SumatiGupta/ASL-Glove-Project/Final Report.pdf

# Project Report: ASL Glove

11/30/2021

Team Members:
Haritha Patil, Indraja Venigandla, Sangam Shrestha, and Sumati Gupta

Table of Contents

Introduction | 4
Problem Description | 4
Project Description | 4
Background | 4
Theory of voltage divider and Operation of Flex Sensors | 4
Theory of UART | 5
Theory of Bluetooth | 6
Theory of I2C and SPI | 6
Operation of HC-05 BT Module | 7
Theory of DMA | 8
Individual aspects of the project | 8
PIT | 8
ADC and DMA triggered ADC | 8
UART and HC-05 connections | 9
I2C, SPI and LCD Screen | 9
16 - segment Display | 11
Calibration and Decode Software | 12
Overall Block Diagram and Flowchart | 14
Results | 17
Performance | 17
Limitations | 17
Alternatives and/or future work | 17
Parallel ADC readings | 17
Increase accuracy | 17
Currently, we take readings from only flex sensors and while this works well most of
the time, there are some inaccuracies due to two factors. | 17
PCB | 18
Since using breadboards is bulky and the external wires can lead to loose connections, we would design and solder a printed circuit board for a more sturdy platform on which the glove operates. This would also lead to a more robust product,
capable of being used in an easier manner. | 18
LCD Screen | 18
Power supply | 18
Video Links showing different Stages of progress | 18
Summary | 19
Reference List (APA Citations) | 19
Appendices | 20
Appendix A | 20

Code for PIT source file | 20
Code for PIT header file | 21
Code for ADC source file | 21
Code for ADC header file | 23
Code for DMA source file | 24
Code for DMA header file | 26
Code for UART TX source file | 26
Code for UART TX header file | 31
Code for Mode detect source file | 32
Code for Mode detect header file | 33
Code for main source file on Transmission MCU | 34
Code for main header file on Transmission MCU | 35
Code for UART RX source file | 35
Code for UART RX header file | 39
Code for calibration and letter decode source file | 39
Code for calibration and letter decode header file | 54
Code for 16 segment source file | 55
Code for 16 segment header file | 60
Code for main source file on Reception MCU | 60
Code for main header file on Reception MCU | 61
Appendix B | 62
Segments of MCU reference Manual | 62
HC-05 Bluetooth Module datasheet segments | 63
16-segment display datasheet segments | 64
Appendix C | 64
Information on data formats and slave devices for I2C. | 65

Introduction

Problem Description
Most people have a hard time understanding American Sign Language (ASL). When they come across a situation where they need to communicate or understand sign language, they require a human or electronic translator. This leads to alienation and miscommunication between two groups of people.

To reduce such alienation, we propose a child-friendly educational tool which will help people get acclimated to and learn sign language.

Project Description
The aim of this project is to design a glove that can be used to teach the ASL alphabet. This glove will have flex sensors integrated into it, which will detect and keep track of various gestures for alphabets used in ASL and display them on a 16-segment display.

Background

Theory of voltage divider and Operation of Flex Sensors
When a voltage source is applied across two resistors in series (where one is connected directly to the source and the other is connected to ground), there is a voltage drop that can be measured across the resistor connected to ground. This voltage drop is the divided voltage and is often referred to as the Vout . The formula used Vout to calculate is:
Vout = Vin * R2___ R1 + R2
, Given the setup in Figure 1

Figure 1: General Voltage Divider circuit [1]

The flex sensor is a resistor that changes resistance based on the bend of the sensor. We connect it in a similar manner to the voltage divider circuit [2]. The Vout

is measured using the
ADC peripheral of the Board. R1 is the flex sensor, R2 is 47kΩ or 51kΩ based on Table 1 and 2, Vin is 5 V output from the MCU and GND is GND from the board

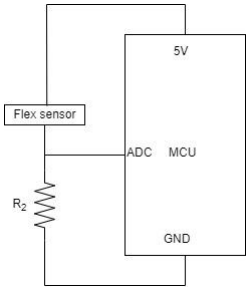
[picture p1: figure]

Figure 2: Flex sensor circuit

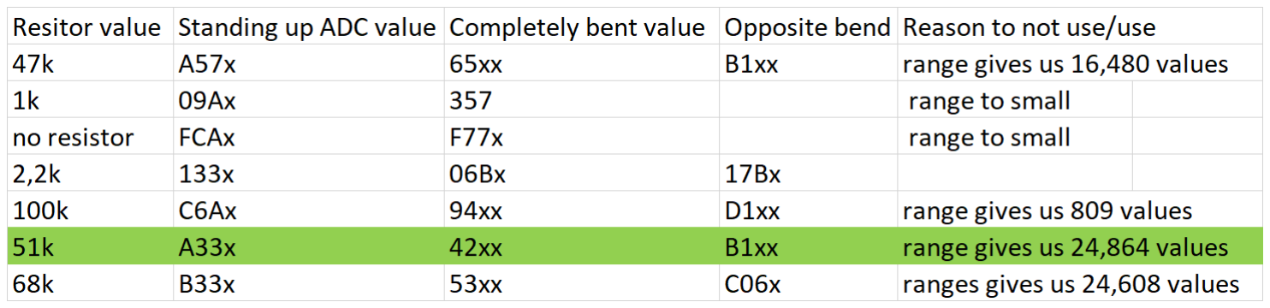
[picture p2: figure]

Table 1: The values from different resistors for small flex sensors. The highlighted one was determined as the best one to use. Here “x” means, it’s fluctuating. Empty cells represent a range that was too small to take into account.

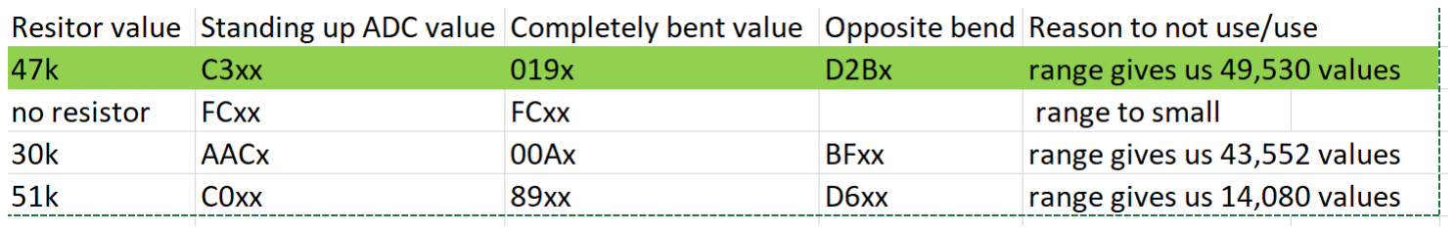
[picture p3: figure]

Table 2: The values from different resistors for long flex sensors. The highlighted one was determined as the best one to use. Here “x” means, it’s fluctuating. Empty cells represent a range that was too small to take into account

Theory of UART
UART stands for Universal Asynchronous Receiver Transmitter. It is a peripheral used for serial communication. The data format and baud rate is configurable using registers on the MCU. Based on configuration, it can be configured to be only a transmitter, only a receiver or both. The transmitter uses a shift register to convert input data to serial data and the receiver uses a shift register to convert serial data into parallel data.

Baud rate refers to the rate at which data is being transferred in bits per second. It is set using the formula, Baud rate = bus clock frequency/(SBR * (OSR +1)), where SBR can be set in BDH and BDL registers and OSR refers to the oversampling rate.

The oversampling rate is used to estimate the middle points of transmitted bits and retrieve these points accordingly [3]. This means that each incoming bit is sampled OSR times and a majority vote is taken.

In our case, the format of data being sent is one start bit, one byte of data, one stop bit

Figure 3: Data format being transmitted and received

Theory of Bluetooth
Bluetooth is a short-range wireless technology standard that is used for exchanging data . A Bluetooth device works by using radio waves instead of wires or cables. [5]

Theory of I2C and SPI
I

2C (Inter-Integrated circuit) bus and SPI (Serial peripheral interface) are used for synchronous serial communication. While I

2C can be used with one master or multiple masters and a single or multiple slave devices, SPI can work with only one master and one or multiple slave devices.

I

2C uses serial data (SDA) signal and serial clock (SCL) signal. A slave may not transmit data unless it has been addressed by the master. Each device on the I2C bus has a specific device address. In our case, since we attempted to work with only one LCD screen as the slave device, we did not need to configure it for multiple slave devices.

In our case, we tried to send data to a slave device (LCD screen and data format is as follows):

Figure 4: Data format that was being sent to screen [6]

In SPI, The MCU is the master and peripheral devices are slaves. In our case, our slave device is the LCD controller. SPI communication between a master and slaves uses three signals(clock and two data signals), a select signal for each slave and ground.
- The clock signal (known as SCK).
- The MOSI data signal is the master output and slave input.
- The MISO data signal is the master input and slave output.
- The SS signal - Slave Select signal.

Baud rate refers to the rate at which data is being transferred in bits per second. It is set using the formula, SPI baud rate = bus clock frequency/((SPPR+1)*2SPR+1), where SPPR and SPR can be set in the SPIx_BR register and I2C baud rate = bus speed/(mulx SCL divider) which can be sent in F register using Table 38-41 in reference Manual (See Appendix B)

Operation of HC-05 BT Module
The HC-05 has EN, VCC, GND, TX, RX, and STATE pins. The HC-05 Bluetooth (BT) Module has two modes “ AT Command '' mode and operation mode. HC-05 Module’s are slaves by default and able to recieve data at the default baud rate and settings.

However to configure the module, we need to go into AT Command mode and configure details of the BT Module. To do this, we require an FTDI reader and the tera term software. We connected the FTDI reader (Micro USB to TTL Serial Converter Adapter) to the computer and once it was detected by the computer’s COM ports. After that, we connected the Rx pin of the FTDI reader to the Tx pin of the Module and the Tx pin to the Rx pin. After which we shorted the Vcc and EN pins of the HC-05 and then we connected the Vcc of the reader to BT Module. The LED on the Module blinked every two seconds indicating it was in AT mode [4].

Once it was in AT mode, we used the tera term software to send data to the HC-05 and using the commands in the HC-05 Datasheet, we set the following configurations.

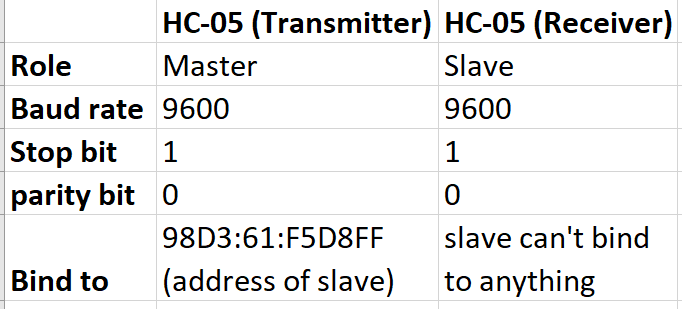
[picture p4: figure]

Table 3: Configurations of HC-05 BT Module’s, Note: Master has to bind to slave address to ensure it always connects to that particular slave device. The address of the slave device was found using an AT command: AT+ADDR?

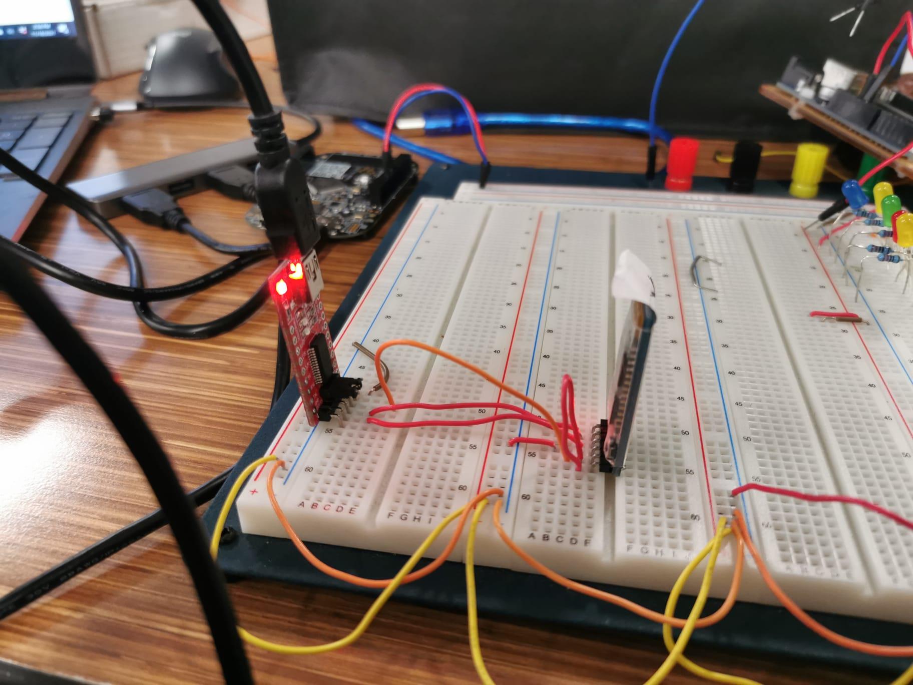
[picture p5: figure]

Figure 4: Connection between HC-05 and FTDI reader

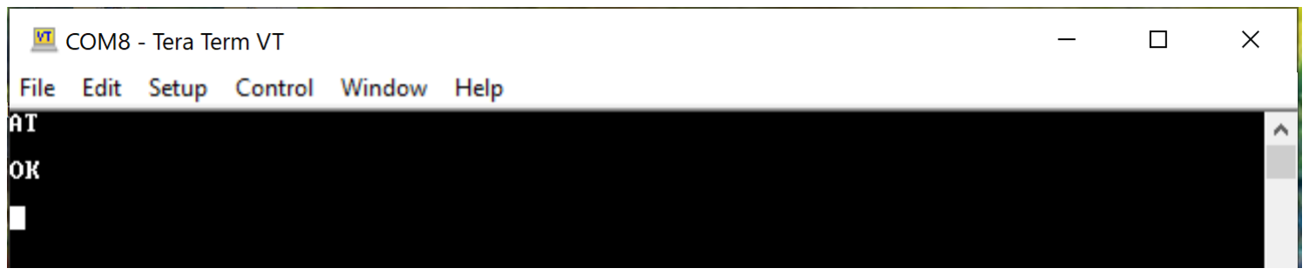
[picture p6: figure]

Figure 5: Picture of Tera Term software

This process is how we ensure that the HC-05 Modules don’t connect to any other bluetooth devices in the vicinity.

Theory of DMA
DMA stands for Direct Memory Access. This peripheral can directly access the MCU’s memory bus directly instead of relying on store and load instructions. Different peripherals can trigger a DMA request. In our case, each ADC conversion triggers a DMA request.

Individual aspects of the project

PIT
The timer PIT is initialized such that 2 channels are utilized. Channel 0 is used for polling adc values every 10 ms by loading 5DBF (10ms*24Mhz - 1 = 23999 cycles or 5DBF) in the LDVAL register for channel 0, and calling a function that starts ADC conversion in the IRQHandler.

Channel 1 is used for updating the flag that indicates mode of operation of the program based on a switch input. Mode of operation refers to calibration mode or performance mode. Once the switch is pressed, it will update every 2 seconds until calibration is over. This is done by loading 2DC6BFF (2*24Mhz - 1 = 47999999 cycles or 2DC6BFF) in LDVAL register for channel 1.

Neither channel uses chaining. The IRQHandler uses the TIF flag in the TFLG register to check which channel triggered the interrupt. The timer restarts when calibration mode is set to avoid unsynchronized data transmission. See Appendix A for code.

ADC and DMA triggered ADC
The ADC is initialized such that there are 5 ADC pins and it is DMA enabled. It uses a 16-bit mode and uses a calibration function after each conversion for accuracy purposes. Once an ADC conversion is over, it triggers the DMA and the DMA transfers the ADC value into an array called GloveInputs. This is done by setting the DMA source to ADC, setting the Source address register in DMA to the result register of the ADC and the Destination address register to the array. We use DMA in circular buffer mode. We increment the destination address, making sure it stores the values sequentially in the correct index value of GloveInputs. Each time a transfer of 16 bits is over, the DMA interrupt occurs, indicating it’s done. We have a counter to keep track of this. See Appendix A for code.

UART and HC-05 connections
We used AT mode as described in “Operation of HC-05” in the Background Section.We use UART0 and UART1. We connected to the UART0 TX pin of the Transmitter MCU (reading glove inputs) to RX of master HC-05 and the UART0 RX pin of the Receiver MCU (displaying the values) to the UART0 TX of the slave HC-05.The UART1 TX pin of the Transmitter MCU is connected to the UART1 RX pin of the Receiver MCU.

We configured both baud rates to 9600 in 8 bit mode. There is one stop and no parity bit.

The Transmitter MCU sends five 16 bit values of ADC and one calibration flag 8 bits at a time using polling once the DMA finishes populating all the elements in GloveInputs. After the values in the array are transmitted, transmission stops until DMA is triggered again. UART1 transmits “1” when UART0 is transmitting valid data and “0” when not.

The receiver MCU interrupts whenever it receives a UART1 transmission, if the value is not 0, it will consider UART0 values as valid inputs and populate an array called “receivedADCread” and decodes the calibration flag to find out mode of operation. The way it populates this array is, it combines two 8 bit values in one 16 bit value and places it an appropriate index (index indicates which finger). See Appendix A for code.

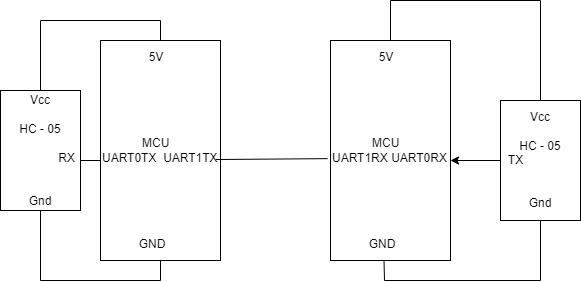
[picture p7: figure]

Figure 6: UART schematic

I2C, SPI and LCD Screen
The SPI is initialized and verified using the SPI loopback test where we figured out the SPI is initialized and the MOSI is sending the data. The figure 5 shows the circuit connection for the SPI initialization. Later, we tried initializing the LCD using the LCD datasheet but couldn't initialize the LCD. The SPI was not sending data to the SPIx_D register. After various consultations with course staff, we moved on to an I

2C LCD screen.

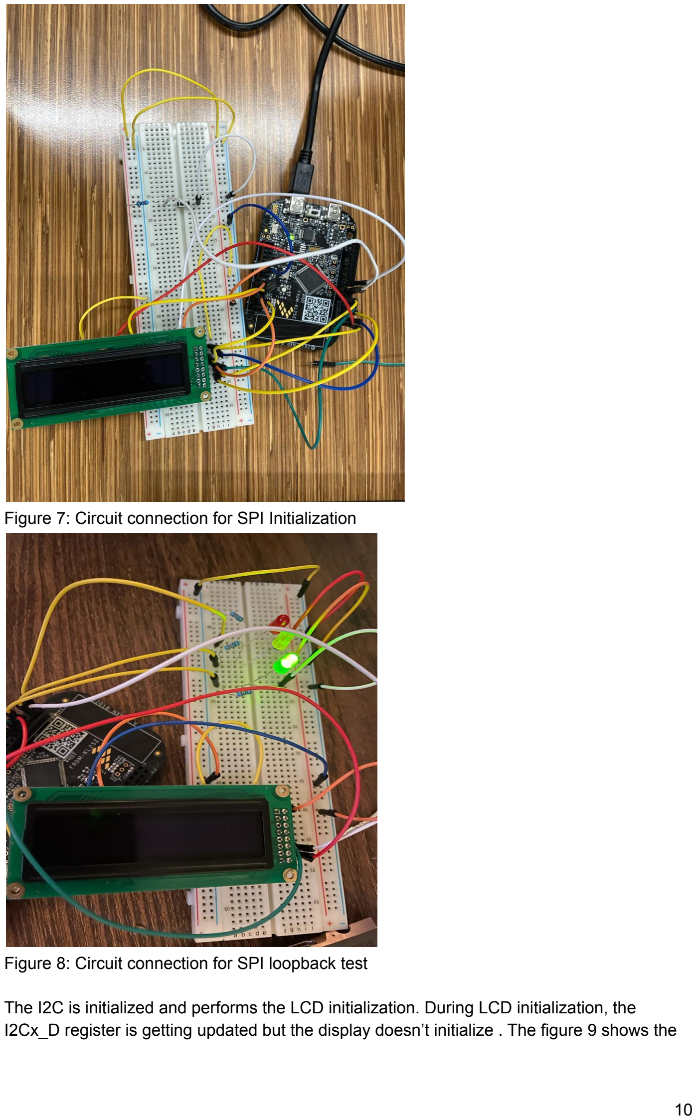
[picture p8: page 10]

Figure 7: Circuit connection for SPI Initialization

Figure 8: Circuit connection for SPI loopback test

The I2C is initialized and performs the LCD initialization. During LCD initialization, the I2Cx_D register is getting updated but the display doesn’t initialize . The figure 9 shows the circuit connection for I2C initialization. Attached is the debug screen shot for the reference as the figure 10.

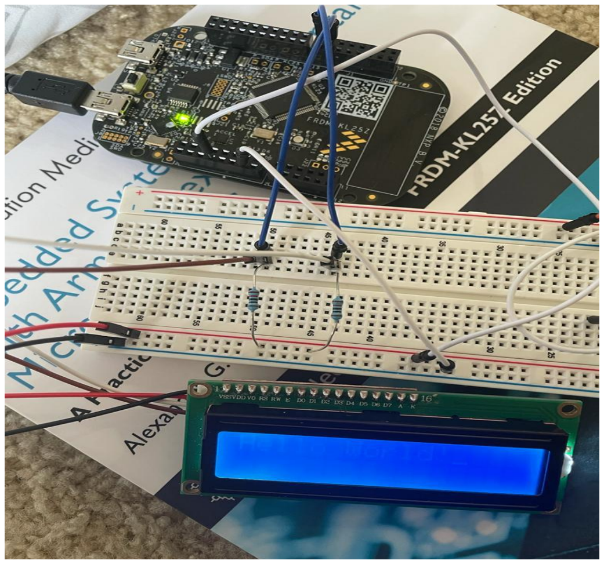
[picture p9: figure]

Figure 9: Circuit connection for Initialization of I2C

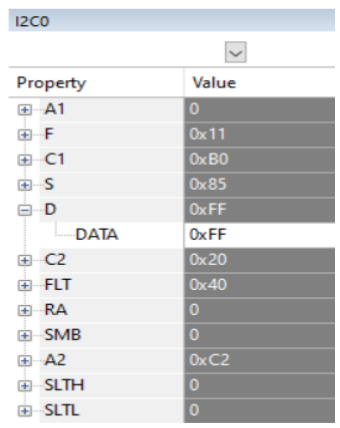
[picture p10: figure]

Figure 10: Debug screen showing D register getting updated

Unfortunately within the scope of our course (the time available), we are unable to figure out the issue. So, we moved on to a 16 segment display.

16 - segment Display
The 16 segment display works with the GPIO. The 16 segments of LED are designated as a,b,c,d,e,f,g,h,k,m,n,p,s,r,t,u and see the figure 11 for reference. We connected all the GPIO ports of the MCU configured as outputs. The segment display receives the input from the decode function and activates the corresponding GPIO ports and displays the output according to that. See Appendix A for code.

Figure 11: 16 Segments of LED

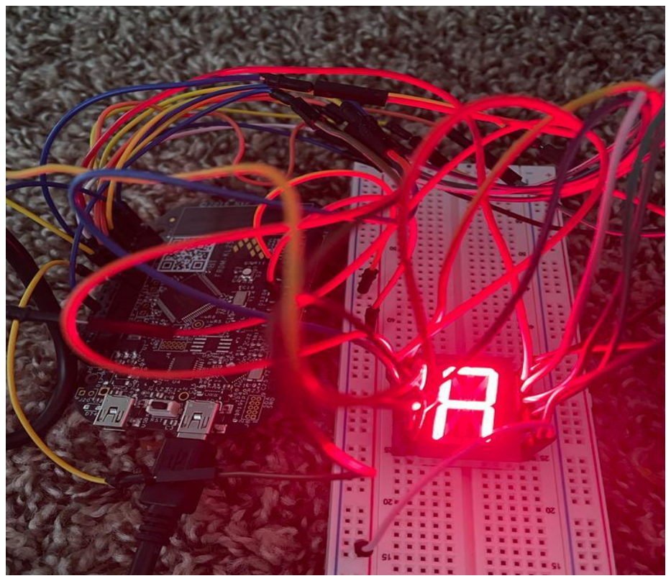
[picture p11: figure]

Figure 12: Circuit connection for 16 Segment display

Calibration and Decode Software

The calibration process is a way to ensure that each set of values read by the ADC can be reliably, and repeatedly mapped to the different letters in the ASL. After the calibration is done, any values read by the ADC needs to be decoded so that the glove knows what letter to display. Both the calibration and decoding procedures are explained in this section:

Calibration

Since the system needs to be able to repeatedly display the same letters given a certain combination of flex sensor readings, it is important to first establish a reference with respect to which we can measure the flexion of the flex sensors. We anticipated that there are three base references that we must establish: the range of values which corresponds to the flex sensor being in the “standing up” position, the range of values which corresponds to the flex sensors being in the “bent” position, and the range of values which corresponds to the flex sensors being in a position that is intermediate to the previous two. This position is referred to as the “middle” position.

This process has a user interface. When the green LED on the freedom board lights up, this means that the MCU is calibrating for the “standing” position, and so the user should keep their hand as straight as possible, so that there is minimal flexion impressed on the flex sensors. After some time, the LED turns red which signifies that the MCU is calibrating for the “bent” position. In this stage, the user should bend his/her fingers so that maximum flexion is impressed on the sensors. After some time, the LED turns off and this means that the user should return to the standing position.The “middle” position is taken as the arithmetic average of the standing and bent positions.

The generated values above are from the user. However, to determine a range of values over which the flex sensor is considered to be in one of standing, middle or bent positions, we need another set of values to which we compare the values generated by the user following the above procedure. This new set of values has been embedded into gloves itself at manufacturing time. We have individually tested each flex sensor and recorded what values they read when configured in the standing, middle and bent positions.

The ranges for the standing, middle and bent positions, then, can be calculated as the difference of the user-generated values and the embedded values. In this way, whenever the ADC detects a particular set of values, it will fall in one of these ranges and we can then use a look-up table (explained below) to determine which letter corresponds to the detected set of values.

Decoding

The look-up table is the data structure which helps in the decoding process. This table is a 2-dimensional array (it contains 26 by 5 elements) which takes the 26 letters of the alphabet and mandates what combination of 5 ADC/flex sensor values (one from each finger) should correspond to that letter.

Once this array is established, then any set of values read by the ADC can be corresponded to a letter and will be displayed on the 16-segment display.

The code to execute the calibration and decoding processes are given the appendix.

Overall Block Diagram and Flowchart

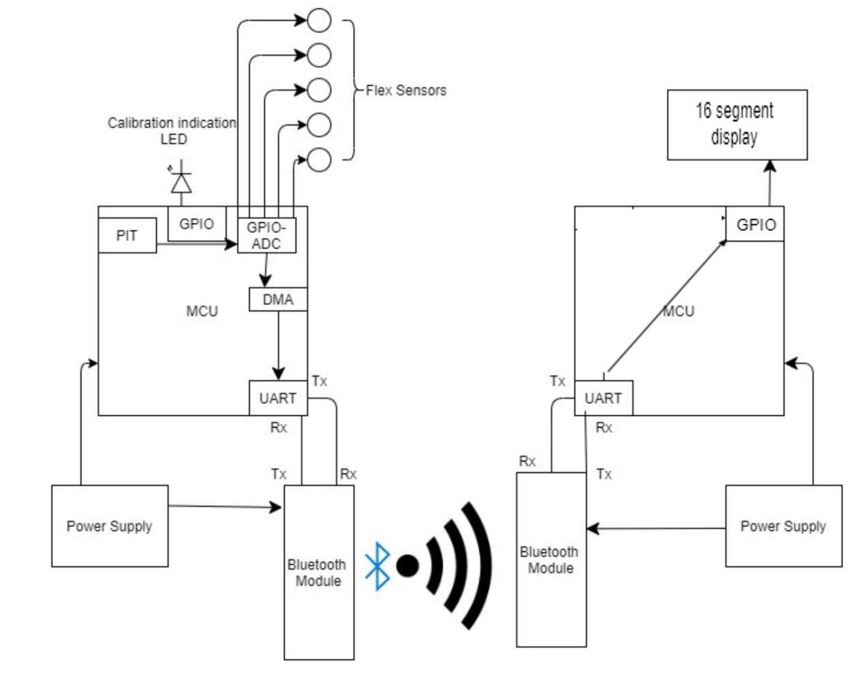
[picture p12: figure]

Figure 13: Block Diagram for overall product

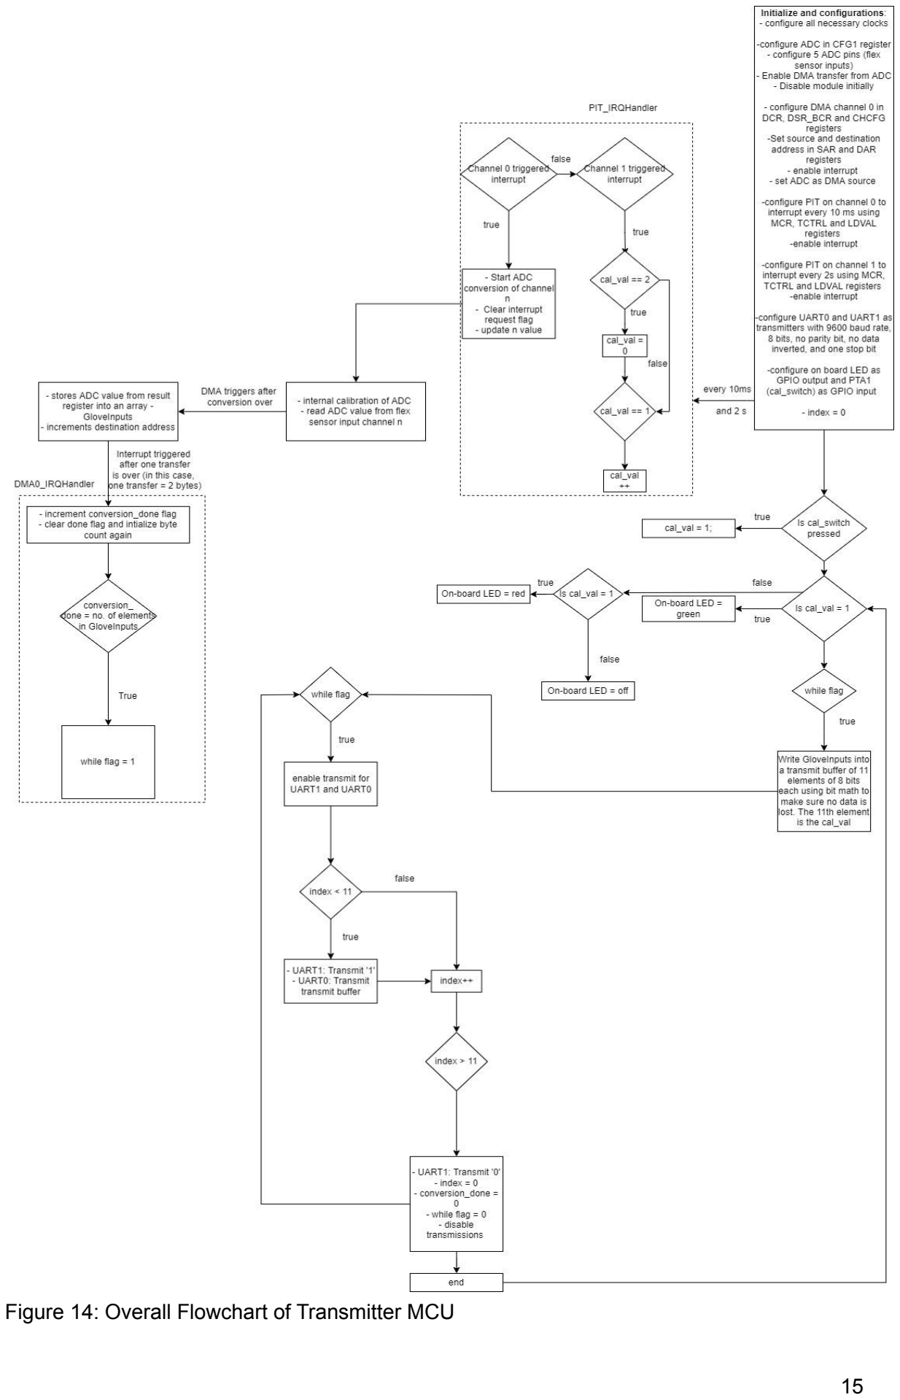
[picture p13: page 15]

Fig

u

r

e

1

4: O

v

e

r

all Flo

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
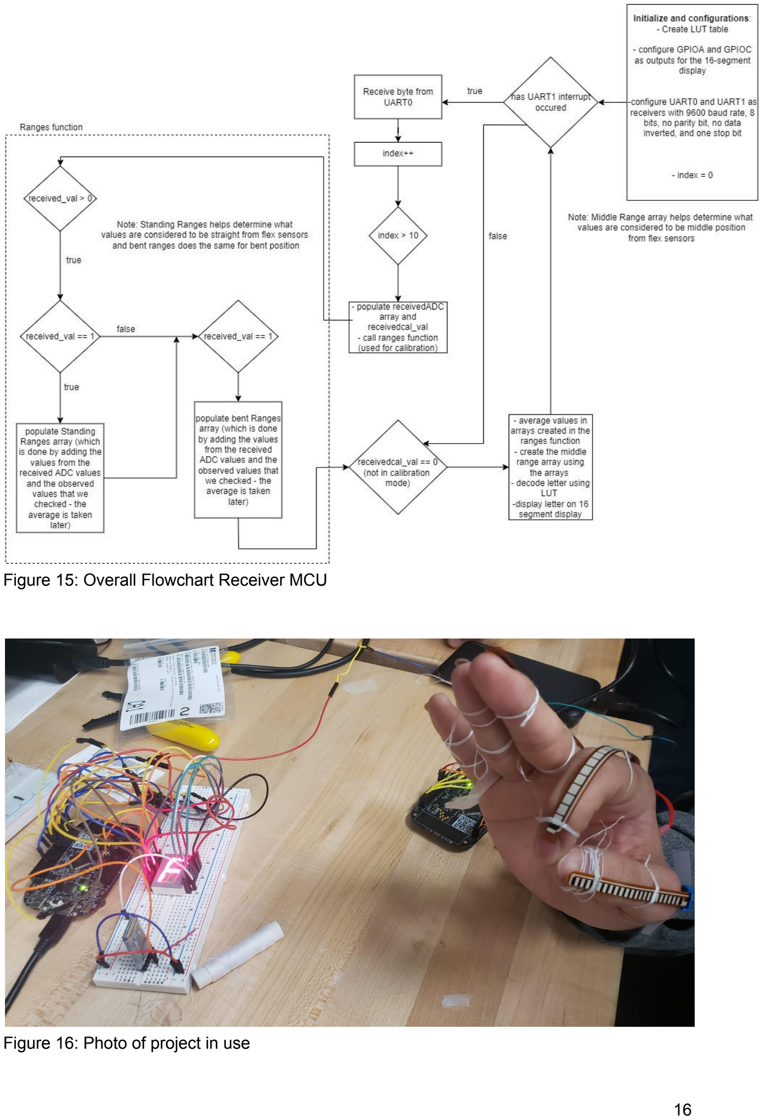
[picture p14: page 16]

Figure 15: Overall Flowchart Receiver MCU

Figure 16: Photo of project in use

Results

Performance

The timers, ADC, DMA, UART, Calibration and letter decoding functions work as expected and the project displays the letter on the segment as expected. When we sign a letter with the flex sensors attached, it is reflected on the screen.

Limitations

1. The flex sensors aren’t stabilized when they are attached to the hand which leads to fluctuating values and the need to be precise in hand positions..
2. Since we can’t determine movement in the fingers, some letters are hard to differentiate. For example the signs for “i” and “j” are the same, except that there is “J” movement with the pinky for “j”.

Figure 17: ASL Letters for i and j

Alternatives and/or future work

Parallel ADC readings

Currently, we sequentially read the ADC values from various pins instead of in a parallel manner. This decision was made after discussion with course staff. However, in the future, it would be efficient if we were able to read it in parallel.

Increase accuracy

Currently, we take readings from only flex sensors and while this works well most of the time, there are some inaccuracies due to two factors.

One factor is that the flex sensors aren’t stabilized when they are attached to the hand and the second factor is that certain ASL letters don’t depend on only the bend angle of the fingers but also movement of fingers. In order to pinpoint the exact location of the hand, we would need to include a gyroscope or an accelerometer.

PCB

Since using breadboards is bulky and the external wires can lead to loose connections, we would design and solder a printed circuit board for a more sturdy platform on which the glove operates. This would also lead to a more robust product, capable of being used in an easier manner.

LCD Screen

We are currently using a 16-segment display. We would like to incorporate an LCD Screen in the future in order to reduce the amount of wires/connections necessary. An LCD screen utilizing the I2C communication protocol only requires 4 wires to power up and use, compared to the 16 connections required for a 16-segment display. Another benefit of the LCD screen is that it is more scalable compared to the 16-segment display. An immediate expansion to the product is the incorporation of words and phrases. An LCD screen would easily allow the user to see what is being said when a certain gesture is made.

Power supply

We are currently using power banks to power the MCUs. We would want to switch to battery packs to make it more compatible with the current market. Since, the 5 V output from the MCU only works when it is connected via USB, this would require a voltage regulator set-up to work with a battery pack.

Video Links showing different Stages of progress

1. DMA working with ADC inputs - https://youtu.be/g7CzWs6c_rA
2. Configuring HC-05 in AT mode - https://youtu.be/fyl2CLJY3aA
3. UART working with HC-05 transmitting one byte - https://youtu.be/caIVNzS3L14
4. UART working with HC-05 transmitting the whole buffer. -https://youtu.be/u_HvwvnnR60
5. Calibration process using the glove - https://youtu.be/7QInGuYTodQ
6. Letter "E" displayed based on flex sensors- https://youtu.be/5Dz7n6EHO3E
7. Letter “Z” displayed based on flex sensors - https://youtu.be/-eKPcRNBViQ
8. Letter "I" displayed based on finger positions - https://youtu.be/3a8Pn2bjF5I
9. Letter “G” and “H” fluctuating based on finger positions -https://youtu.be/s1mzhiopUj8
10. Letter "L" displayed based on finger positions - https://youtu.be/M8MpVGRHP30
11. Letter "D" displayed based on finger positions - https://youtu.be/m7DSW6J3_eg
12. Letters "A", "B", and "C" displayed based on finger positions -https://youtu.be/_WVLcP_ZgN8

Summary

The ASL glove is a product designed to help interested individuals in learning the basics of ASL. This device makes use of several peripherals found in the MKL25Z128VLK4 microcontroller. These peripherals were: the UART0 and UART 1 modules, the ADC, the DMA, the PIT, and the GPIOs.

The overall program flow of the device is as follows:

The PIT triggers an interrupt every 10 ms which signals the ADC to read the values from the GPIO pins. Upon the completion of every conversion, the ADC requests the DMA to save the value into an array in memory. Once the array is filled with all the sampled values from all the GPIO pins, the UART1 module sends a random character to the receiver. Once the receiver receives the character, it triggers an interrupt which signals the UART0 module to start polling for the array. The transmitter transmits the array to the receiver, and the receiver uses its look-up table to decode and display the proper letter to the 16-segment display.

Reference List (APA Citations)

1. Voltage Dividers. Sparkfun. (n.d.). Retrieved November 30, 2021, from https://learn.sparkfun.com/tutorials/voltage-dividers/all
2. Flex Sensor Hookup Guide. Sparkfun. (n.d.). Retrieved November 30, 2021, from https://learn.sparkfun.com/tutorials/flex-sensor-hookup-guide/all#example-circuit
3. UART (universal asyncronous receiver & transmitter). Weebly. (n.d.). Retrieved November 30, 2021, from
https://robo-tronix.weebly.com/uploads/2/3/2/1/23219916/uart_design_doc.pdf
4. sayem2603, & Instructables. (2017, October 14). At command mode of HC-05 and HC-06 Bluetooth module. Instructables. Retrieved November 30, 2021, from https://www.instructables.com/AT-command-mode-of-HC-05-Bluetooth-module/
5. How does a bluetooth headset work? Jabra. (n.d.). Retrieved November 30, 2021, from
https://www.jabra.com/fq/how-does-bluetooth-headset-work#:~:text=A%20Bluetooth %C2%AE%20device%20works,cell%20phone%2C%20smartphone%20or%20comp uter.&text=A%20single%20Bluetooth%20headset%20can,bother%20of%20wires%20 or%20cords (https://www.jabra.com/fq/how-does-bluetooth-headset-work)
6. Noel, P. A. (n. d.). Lecture on Serial Communications Chapter 8 by Dr Alexander G Dean. Personal Collection of P. A. Noel II, Oakland University, Rochester Hills, MI.

Appendices

Appendix A

Code for PIT source file
1 #include "pit.h"
2
3 int counter = 0;
4
5 void pit_init(void)
6 {
7 | // Enable PIT clock
8 | SIM->SCGC6 |= SIM_SCGC6_PIT_MASK;
9
10
11 // Turn on PIT - clear MDIS bit in MCR reg 12 PIT->MCR &= ~PIT_MCR_MDIS_MASK;
13 //freeze timer in debug mode
14 PIT->MCR |= PIT_MCR_FRZ_MASK;
15
16 // Configure PIT to produce an interrupt every 1s on Timer 0
17 PIT->CHANNEL[0].LDVAL = PIT_LDVAL_TSV(0x5DBF); // 1ms*24Mhz - 1 = 23999 cycles or 5DBF
18 // Enable interrupt and enable timer
19 PIT->CHANNEL[0].TCTRL |= PIT_TCTRL_TIE_MASK | PIT_TCTRL_TEN_MASK;
20 //set "no chaining"
21 PIT->CHANNEL[0].TCTRL &= ~PIT_TCTRL_CHN_MASK;
22
23 // Configure PIT to produce an interrupt every 2s on Timer 1
24 PIT->CHANNEL[1].LDVAL = PIT_LDVAL_TSV(0x2DC6BFF); // 2*24Mhz - 1 = 47999999 cycles or 2DC6BFF
25 // Enable interrupt and enable timer
26 PIT->CHANNEL[1].TCTRL |= PIT_TCTRL_TIE_MASK | PIT_TCTRL_TEN_MASK;
27 //set "no chaining"
28 PIT->CHANNEL[1].TCTRL &= ~PIT_TCTRL_CHN_MASK;
29
30
31 // Enable interrupt
32 NVIC_SetPriority(PIT_IRQn, 0); 33 NVIC_ClearPendingIRQ(PIT_IRQn); 34 NVIC_EnableIRQ(PIT_IRQn);
35 __enable_irq();
36
37 }
38
39 void PIT_IRQHandler(void)
40 {
41 //Can chose to check channel int flag
42 if(PIT->CHANNEL[0].TFLG & PIT_TFLG_TIF_MASK){
43 | adc_read(counter);
44 | counter += 1;
45 | if (counter == 8){

46 | counter = 0;
47 | }
48 | //Clear interrupt request flag for channel by writing one to it -
slide 12 of chapter 7
49 | PIT->CHANNEL[0].TFLG |= PIT_TFLG_TIF_MASK;
50 }
51
52 else if(PIT->CHANNEL[1].TFLG & PIT_TFLG_TIF_MASK) 53 {
54 | if (cal_val == 2)
55 | cal_val = 0;
56 | else if (cal_val == 1)
57 | cal_val++;
58
59 //Clear interrupt request flag for channel by writing one to it - slide 12 of chapter 7
60 | PIT->CHANNEL[1].TFLG |= PIT_TFLG_TIF_MASK;
61 }
62
63 }
64
Code for PIT header file
1 #include <MKL25Z4.h>
2 #include "adc.h"
3 #include "read.h"
4
5 extern int counter;
6
7 void pit_init(void);
8 void PIT_IRQHandler(void); 9
Code for ADC source file
1 #include "adc.h"
2
3 int CH_idx[8];
4
5 void adc_init(void)
6 {
7 | // Enable clocks
8 | SIM->SCGC6 |= SIM_SCGC6_ADC0_MASK; // ADC0 clock
9 | SIM->SCGC5 |= SIM_SCGC5_PORTB_MASK; // PortB clock
10 SIM->SCGC5 |= SIM_SCGC5_PORTE_MASK; // Port E clock 11
12
13 // Configure ADC
14 ADC0->CFG1 = 0; // Reset register
15 ADC0->CFG1 |= (ADC_CFG1_MODE(3) | | // 16 bits mode
16 | ADC_CFG1_ADICLK(0)| | // Input Bus Clock (20-25 MHz out of
reset (FEI mode))
17 | ADC_CFG1_ADIV(0)) | | // Clock divide by 1
18 | ADC_CFG1_ADLPC_MASK //low power configuration
19 | ; // short sample time
20

21 //Select analog pin for 5 fingers
22 PORTB->PCR[ADCpinky] &= ~PORT_PCR_MUX_MASK; 23 PORTB->PCR[ADCpinky] |= PORT_PCR_MUX(0); 24 PORTB->PCR[ADCring] &= ~PORT_PCR_MUX_MASK; 25 PORTB->PCR[ADCring] |= PORT_PCR_MUX(0);
26 PORTB->PCR[ADCmiddle] &= ~PORT_PCR_MUX_MASK; 27 PORTB->PCR[ADCmiddle] |= PORT_PCR_MUX(0); 28 PORTB->PCR[ADCindex] &= ~PORT_PCR_MUX_MASK; 29 PORTB->PCR[ADCindex] |= PORT_PCR_MUX(0); 30 PORTE->PCR[ADCthumb] &= ~PORT_PCR_MUX_MASK;
31 PORTE->PCR[ADCthumb] |= PORT_PCR_MUX(0);
32
33 ADC0->SC2 |= ADC_SC2_DMAEN_MASK; // DMA Enable 34
35 ADC0_SC3 = 0; // Reset SC3
36
37 ADC0_SC1A |= ADC_SC1_ADCH(31); // Disable module initially. Change the channel value once we start using it.
38
39 CH_idx[0] = ADCpinky_CH;
40 CH_idx[1] = ADCring_CH;
41 CH_idx[2] = ADCmiddle_CH; 42 CH_idx[3] = ADCindex_CH; 43 CH_idx[4] = ADCthumb_CH; 44 CH_idx[5] = 0x10;
45 CH_idx[6] = 0x10;
46 CH_idx[7] = 0x10;
47
48 }
49
50 //Refer to page 494 to 495 for instructions on calibration procedure 51
52 int internal_calibration_adc(void)
53 {
54 uint16_t cal_var = 0; // calibration variable
55
56 ADC0_CFG1 |= (ADC_CFG1_MODE(3) | | // 16 bit mode
57 | ADC_CFG1_ADICLK(1)| // Input Bus Clock divided by 2 (20-25
MHz out of reset (FEI mode) / 2)
58 | ADC_CFG1_ADIV(2)) ; // Clock divide by 4 (2.5-3 MHz)
59
60 ADC0_SC3 |= ADC_SC3_AVGE_MASK | | // Enable HW average
61 | ADC_SC3_AVGS(3) | | | // Set HW average of 32 samples
62 | ADC_SC3_CAL_MASK; | | // Start calibration process
63
64 while(ADC0_SC3 & ADC_SC3_CAL_MASK); // Wait for calibration to end
65
66 if(ADC0_SC3 & ADC_SC3_CALF_MASK) | // Check for successful calibration
67 | return 1;
68
69 //Do the following procedure for both plus and minus sides
70 cal_var += ADC0_CLPS + ADC0_CLP4 + ADC0_CLP3 +
71 | ADC0_CLP2 + ADC0_CLP1 + ADC0_CLP0;

72 cal_var = cal_var >> 2;
73 cal_var |= ADC_set_MSB; // Set MSB
74 ADC0_PG = cal_var;
75 cal_var = 0;
76 cal_var += ADC0_CLMS + ADC0_CLM4 + ADC0_CLM3 +
77 | ADC0_CLM2 + ADC0_CLM1 + ADC0_CLM0;
78 cal_var = cal_var >> 2;
79 cal_var |= ADC_set_MSB; // Set MSB
80 ADC0_MG = cal_var;
81
82 return 0;
83 }
84
85 void adc_read(int i){
86
87 //clear coco to start conversion on for all channels - bits 4 - 0 in ADCx_SC1n selects the input channel
88 // call the calibration function before each conversion
89
90 internal_calibration_adc();
91 ADC0->SC1[0] = CH_idx[i];
92 ADC0->SC1[0] &= ~ADC_SC1_COCO_MASK; 93
94 }
95

Code for ADC header file
1 #include <MKL25Z4.h>
2
3 #define ADCpinky | (0) //port B - ADC0_SE8, Channel: AD8, ADC
Channel:01000
4 #define ADCring | (1) //port B - ADC0_SE9, Channel: AD9, ADC
Channel:01001
5 #define ADCmiddle | (2) //port B - ADC0_SE12, Channel: AD12, ADC
Channel:01100
6 #define ADCindex | (3) //port B - ADC0_SE13, Channel: AD13, ADC
Channel:01101
7 #define ADCthumb | (20) //port E - ADC0_DP0/SE0, Channel: DAD0,
ADC Channel:00000
8
9 #define ADCpinky_CH | (0x8)
10 #define ADCring_CH | (0x9)
11 #define ADCmiddle_CH | (0xc)
12 #define ADCindex_CH | (0xd)
13 #define ADCthumb_CH | (0x0)
14
15 #define ADC_set_MSB (0x8000) 16
17 extern int CH_idx[8];
18
19 void adc_init(void);
20 void adc_read(int i);
21 int internal_calibration_adc(void);

22

Code for DMA source file

1 #include "dma.h"
2
3 //variable definitions
4 uint32_t GloveInputs[8];
5 volatile int conversion_done = 0; 6 int while_flag = 0;
7
8 //test
9 #define CONVERSION_LED (5) //on port A 10 #define MASK(x) (1UL << (x))
11
12 void dma_init(void)
13 {
14 // Enable clocks
15 SIM->SCGC6 |= SIM_SCGC6_DMAMUX_MASK; 16 SIM->SCGC7 |= SIM_SCGC7_DMA_MASK; 17
18 // Config DMA Mux for ADC operation 19 // Disable DMA Mux channel first
20 DMAMUX0->CHCFG[0] = 0x00;
21
22 //configure DMA_SAR to read the ADC_Rn
23 //configure DMA_DAR to write in array
24 DMA0->DMA[0].SAR = DMA_SAR_SAR((uint32_t *)(&(ADC0->R[0]))); 25 DMA0->DMA[0].DAR = DMA_DAR_DAR((uint32_t *)GloveInputs);
26
27
28 // initialize byte count - 2 bytes at a time - 16 bits. 16 bits selected since ADC in 16 bit mode
29 DMA0->DMA[0].DSR_BCR = DMA_DSR_BCR_BCR(2);
30
31 //if we want to force one read at a time - this means two bytes is one read
32 DMA0->DMA[0].DCR |= DMA_DCR_CS_MASK;
33
34 DMA0->DMA[0].DCR |= (DMA_DCR_EINT_MASK| // Enable interrupt each time transfer is over
35 | DMA_DCR_ERQ_MASK | | // Enable peripheral request
36 | DMA_DCR_SSIZE(2) | | // Set source size to 16 bits
37 | DMA_DCR_DINC_MASK| | // Set increments to destination
address
38 | DMA_DCR_DMOD(2) | | // Destination address modulo of 16
bytes
39 | DMA_DCR_DSIZE(2)); | // Set destination size of 16 bits
40 | //set bit 24 to 0 (a requirement)
41 DMA0->DMA[0].DCR &= ~DMA_DCR_SINC_MASK; //clears source increment
42
43 DMA0->DMA[0].DCR |= DMA_DCR_EADREQ_MASK; // changed in office hours 44

45
46 // Enable interrupt
47 NVIC_SetPriority(DMA0_IRQn, 2); 48 NVIC_ClearPendingIRQ(DMA0_IRQn); 49 NVIC_EnableIRQ(DMA0_IRQn);
50
51
52 // Enable DMA channel and source - ADC0 = 40 based on Table 3-20: DMA request sources
53 DMAMUX0->CHCFG[0] |= DMAMUX_CHCFG_SOURCE(40); // Enable DMA channel and set ADC0 as source
54 DMAMUX0->CHCFG[0] |= DMAMUX_CHCFG_ENBL_MASK;
55
56 /*if ((DMA0->DMA[0].DAR >= GloveInputs) && (DMA0->DMA[0].DAR <= (GloveInputs + 5))){
57 | DMAMUX0->CHCFG[0] |= DMAMUX_CHCFG_ENBL_MASK;
58 }
59 else{
60 | //DMAMUX0->CHCFG[0] = 0x00;
61 | DMA0->DMA[0].DAR = DMA_DAR_DAR((uint32_t *)GloveInputs);
62 | DMAMUX0->CHCFG[0] |= DMAMUX_CHCFG_ENBL_MASK;
63 }*/
64
65 DMA0->DMA[0].DSR_BCR &= ~DMA_DSR_BCR_DONE_MASK;
66
67
68 }
69
70 void DMA0_IRQHandler(void) 71 {
72 conversion_done += 1;
73
74 //everytime conversion completes, clears BCR to 0, so we need to clear done flag and initialize byte count again
75 DMA0->DMA[0].DSR_BCR |= DMA_DSR_BCR_DONE_MASK; // Clear Done Flag -write to it to clear it
76 DMA0->DMA[0].DSR_BCR = DMA_DSR_BCR_BCR(2); //initialize byte count again
77
78
79 if (conversion_done == 8) 80 {
81 | //UART stuff
82 | /*TransmitBufferCreate();
83 | while_flag = 1;
84 | UART0->C2 |= UART0_C2_TE_MASK;
85 | while(while_flag)
86 | {
87 | //UART0_Transmit_DMA(index);
88 | index++;
89 | if(index > 11) //if you change 11 to a 10, the uart might be on the
cusp of sending/not sending

90 | //11 gives the uart plenty of time to
reset the index, etc.
91 | {
92 | UART0->C2 &= ~UART0_C2_TE_MASK; //disable interrupt once all
values are transferred
93 | index = 0;
94 | while_flag = 0; //stops while loop
95 | }
96 | }*/
97 | while_flag = 1;
98 | //conversion_done = 0;
99 }
100
101
102 }
103

Code for DMA header file
1 #ifndef DMA_H
2 #define DMA_H
3
4 #include <MKL25Z4.h>
5 #include "UART.h"
6 #include "adc.h"
7 #include "pit.h"
8
9 #define pinky_index (0)
10 #define ring_index (1)
11 #define middle_index (2) 12 #define index_index (3) 13 #define thumb_index (4)
14
15 //variable declarations
16 extern volatile int conversion_done; 17 extern uint32_t GloveInputs[8]; 18 extern int while_flag;
19 extern volatile int conversion_done; 20 void dma_init(void);
21 void DMA0_IRQHandler(void);
22
23 #endif
24
25 //Note: added ifndef and endif to get rid of "include nested too deeply" 26 //error

Code for UART TX source file
1 #include "UART.h"
2
3 //UART TX
4 int shiftedpinky = 0;
5 int shiftedring = 0;
6 int shiftedmiddle = 0;
7 int shiftedindex = 0;

8 int shiftedthumb = 0;
9 //uint8_t cal_val = 0;
10 uint8_t transmitbuffer[11]; 11 //uint32_t GloveInputs[8];
12
13 //Debug
14 unsigned char Transmit_Done = 0; 15
16
17 void Init_UART(void)
18 {
19 // Let's use UART0 and PTB
20 // Enable clock gating for UART0 and Port B 21
22 uint16_t sbr;
23
24 //We use transmit data to LCD screen and maybe eventually receive (for error check)
25 //Since the UART can only take 8 bits, and we have 5 important 16 bit values that
26 //need to be sent, we would have to fill D reg with each half of an array element
27 //making it a total of 5*2 times D needs to be updated.
28 SIM->SCGC4 |= SIM_SCGC4_UART0_MASK;
29 SIM->SCGC5 |= SIM_SCGC5_PORTA_MASK;
30
31 // Make sure transmitter and receiver are disabled before configuring 32 UART0->C2 &= ~UART0_C2_TE_MASK & ~UART0_C2_RE_MASK;
33
34 // UART 1 has to use Bus Clock, clock can't be configured
35 // according to table 5-2 (page 122) of reference manual
36 // and absence of macors
37 // but UART0 clock needs to be set - to 48 MHz clock in this case 38 SIM->SOPT2 |= SIM_SOPT2_UART0SRC(1);
39 //SIM->SOPT2 |= SIM_SOPT2_PLLFLLSEL_MASK;
40
41 // Set pins to UART0 Rx and Tx
42 PORTA->PCR[TX_PIN] |= PORT_PCR_MUX(2); // Tx 43
44
45 // Set baud rate and oversampling ratio
46 sbr = (uint16_t)((CLOCK)/(BAUD_RATE * OVERSAMPLE_RATE)) - 32 ; 47 UART0->BDH &= ~UART0_BDH_SBR_MASK;
48 UART0->BDH |= UART0_BDH_SBR(0x1F & (sbr>>8));
49 UART0->BDL = UART0_BDL_SBR(sbr);
50 UART0->C4 |= UART0_C4_OSR(OVERSAMPLE_RATE - 1); //UARTLP_C4_OSR(x) is same as UART0_C4_OSR(x) and since C4 reg all UART is same, it should work 51
52 //LIN break is high whenever a break is detected.
53 //I believe this occurs when there is empty space in a transmission or recieve line
54 //this will set LBKDIF bit in UARTx_S2 as a high.
55 //setting LBKDIE bit in BDH reg will cause an interrupt if LBKDIF is high

56 UART0->BDH |= UART0_BDH_LBKDIE(0); // for now let's disable it
57 UART0->BDH |= UART0_BDH_RXEDGIE(0); // Disable interrupts for RX active edge
58 UART0->BDH |= UART0_BDH_SBNS(0); // one stop-bit - only two options 1 or 2
59 | // Its logic level is the same as the signal's idle
state, i.e., logic high
60 UART0->C1 |= UART0_C1_M(0); //Data bit mode - 8 bits - In 8-bit data mode, the shift register holds a
61 | //start bit, eight data bits, and a stop bit.
62 | UART0->C1 |= UART0_C1_LOOPS(0); //0: Normal operation - RxD and TxD use
separate pins.
63 UART0->C1 |= UART0_C1_PE(0); | //Don't use parity bit
64 | //We can use parity bit but will need to change bit
mode to 9 - The 9-bit data mode is typically used with parity to allow eight bits of data plus the parity in the ninth bit
65 | //When parity is enabled, the bit immediately before
the stop bit is treated as the parity bit
66 | // a little confused about D being only 8 bits long
67 | // will also need to set PT bit in C1 to parity odd
or even and enable interrupt for parity (PEIE) in C3
68
69 // Don't enable interrupts for errors
70 UART0->C3 = UART0_C3_ORIE(0)| UART0_C3_NEIE(0) | UART0_C3_FEIE(0) |
UART0_C3_PEIE(0);
71
72 // Clear error flags
73 UART0->S1 |= UART0_S1_OR(1) | UART0_S1_NF(1) | UART0_S1_FE(1) |
UART0_S1_PF(1); //To clear these flags write logic one to them
74
75 | UART0->S2 = UART0_S2_MSBF(0); //do not invert received data
76 UART0 -> C3 = UART0_C3_TXINV(0); //Send LSB first, do not invert transmitted data
77
78
79 //POSSIBLE NEED IN CASE OF RECEIVER
80 //If Receive Data Register Full Flag (RDRF bit) in UARTx_S1 is high and 81 //setting RIE bit in C2 reg will cause an interrupt - clear flag initially at end of init (based on textbook)
82 //UART0->C2 |= UART_C2_RIE_MASK;
83
84 UART0->C2 |= UART0_C2_TE(1); // Enable UART transmitter 85 }
86
87 void Init_UART1(void)
88 {
89 // Let's use UART0 and PTB
90 // Enable clock gating for UART0 and Port B 91
92 uint16_t sbr;
93
94 //We use transmit data to LCD screen and maybe eventually receive (for error check)

95 //Since the UART can only take 8 bits, and we have 5 important 16 bit values that
96 //need to be sent, we would have to fill D reg with each half of an array element
97 //making it a total of 5*2 times D needs to be updated.
98 SIM->SCGC4 |= SIM_SCGC4_UART1_MASK;
99 SIM->SCGC5 |= SIM_SCGC5_PORTC_MASK;
100
101 | // Make sure transmitter and receiver are disabled before configuring
102 | UART1->C2 &= ~UART_C2_TE_MASK & ~UART_C2_RE_MASK;
103
104 | // UART 1 has to use Bus Clock, clock can't be configured
105 | // according to table 5-2 (page 122) of reference manual
106 | // and absence of macors
107 | // but UART0 clock needs to be set - to 48 MHz clock in this case
108 | //SIM->SOPT2 |= SIM_SOPT2_UART0SRC(1);
109 | //SIM->SOPT2 |= SIM_SOPT2_PLLFLLSEL_MASK;
110
111 | // Set pins to UART0 Rx and Tx
112 | PORTC->PCR[4] |= PORT_PCR_MUX(3); // Tx
113
114
115 | // Set baud rate and oversampling ratio
116 | sbr = (uint16_t)((CLOCK)/(BAUD_RATE * 16)) - 32 ;
117 | UART1->BDH &= ~UART_BDH_SBR_MASK;
118 | UART1->BDH |= UART_BDH_SBR(0x1F & (sbr>>8));
119 | UART1->BDL = UART_BDL_SBR(sbr);
120 | //UART1->C4 |= UARTLP_C4_OSR(OVERSAMPLE_RATE - 1); //UARTLP_C4_OSR(x)
is same as UART0_C4_OSR(x) and since C4 reg all UART is same, it should work 121
122 | //LIN break is high whenever a break is detected.
123 | //I believe this occurs when there is empty space in a transmission
or recieve line
124 | //this will set LBKDIF bit in UARTx_S2 as a high.
125 | //setting LBKDIE bit in BDH reg will cause an interrupt if LBKDIF is
high
126 | UART1->BDH |= UART_BDH_LBKDIE(0); // for now let's disable it
127 | UART1->BDH |= UART_BDH_RXEDGIE(0); // Disable interrupts for RX
active edge
128 | UART1->BDH |= UART_BDH_SBNS(0); | // one stop-bit - only two options
1 or 2
129 | // Its logic level is the same as the signal's idle
state, i.e., logic high
130 UART1->C1 |= UART_C1_M(0); //Data bit mode - 8 bits - In 8-bit data mode, the shift register holds a
131 | //start bit, eight data bits, and a stop bit.
132 | UART1->C1 |= UART_C1_LOOPS(0); //0: Normal operation - RxD and TxD use
separate pins.
133 | UART1->C1 |= UART_C1_PE(0); //Don't use parity bit
134 | //We can use parity bit but will need to change
bit mode to 9 - The 9-bit data mode is typically used with parity to allow eight bits of data plus the parity in the ninth bit

//When parity is enabled, the bit immediately before the stop bit is treated as the parity bit // a little confused about D being only 8 bits long
// will also need to set PT bit in C1 to parity odd or even and enable interrupt for parity (PEIE) in C3

// Don't enable interrupts for errors
UART1->C3 = UART_C3_ORIE(0)| UART_C3_NEIE(0) | UART_C3_FEIE(0) |
UART_C3_PEIE(0);

// Clear error flags
//UART1->S1 |= UART_S1_OR(1) | UART_S1_NF(1) | UART_S1_FE(1) |
UART_S1_PF(1); //To clear these flags write logic one to them

UART1->S2 &= ~UARTLP_S2_MSBF_MASK; //do not invert recieved data UART1 -> C3 = UART_C3_TXINV(0); //Send LSB first, do not invert transmitted data

//POSSIBLE NEED IN CASE OF RECEIVER
//If Receive Data Register Full Flag (RDRF bit) in UARTx_S1 is high and
//setting RIE bit in C2 reg will cause an interrupt - clear flag initially at end of init (based on textbook) //UART0->C2 |= UART_C2_RIE_MASK;

UART1->C2 |= UART_C2_TE(1); // Enable UART transmitter
155 }

157 void UART0_Transmit_DMA(int index) {

while (!(UART0->S1 & UART0_S1_TDRE_MASK)) ;
UART0->D = (uint8_t)(transmitbuffer[index]);

if (!(UART0->S1 & UART0_S1_TDRE_MASK)) Transmit_Done++;
165 }

167 void UART1_Transmit(int value) 168 {
while (!(UART1->S1 & UART_S1_TDRE_MASK)) ;
UART1->D = (uint8_t)(value);
172 }

174 void UART0_Transmit_OneByte() {

while (!(UART0->S1 & UART0_S1_TDRE_MASK)) ;
UART0->D = (uint8_t)(0x11);

180 | if (!(UART0->S1 & UART0_S1_TDRE_MASK))
181 | Transmit_Done++;
182
183
184 }
185
186 //function will be in UARTTX
187 void TransmitBufferCreate(){
188
189 | shiftedpinky = GLOVEMASK(GloveInputs[pinky_index]);
190 | shiftedring = GLOVEMASK(GloveInputs[ring_index]);
191 | shiftedmiddle = GLOVEMASK(GloveInputs[middle_index]);
192 | shiftedindex = GLOVEMASK(GloveInputs[index_index]);
193 | shiftedthumb = GLOVEMASK(GloveInputs[thumb_index]);
194
195 | transmitbuffer[0] = LSB(shiftedpinky);
196 | transmitbuffer[1] = MSB(shiftedpinky);
197 | transmitbuffer[2] = LSB(shiftedring);
198 | transmitbuffer[3] = MSB(shiftedring);
199 | transmitbuffer[4] = LSB(shiftedmiddle);
200 | transmitbuffer[5] = MSB(shiftedmiddle);
201 | transmitbuffer[6] = LSB(shiftedindex);
202 | transmitbuffer[7] = MSB(shiftedindex);
203 | transmitbuffer[8] = LSB(shiftedthumb);
204 | transmitbuffer[9] = MSB(shiftedthumb);
205 | transmitbuffer[10] = cal_val;
206 }
207
208 //Note: took out unneeded variables in .h file and .c file that was 209 //meant for only RX
210

Code for UART TX header file
1 #ifndef UART_H
2 #define UART_H
3
4 #include <MKL25Z4.h>
5 #include "dma.h"
6 #include "read.h"
7
8 //declarations in UART RX
9
10 #define BAUD_RATE | (9600)
11 #define OVERSAMPLE_RATE (25)
12 #define CLOCK | (24000000)
13
14 #define TX_PIN | (2) //on port A - ALT 2 is UART0_Tx
15
16 #define LSB(x) | (uint8_t)(x & 0x00FF)
17 #define MSB(x) | (uint8_t)((x & 0xFF00) >> 8)
18 #define GLOVEMASK(x) | ((x) >> 16)
19 #define COMBINE(MSB, LSB) (uint16_t)(((uint16_t)MSB << 8) | LSB)
20

21 void Init_UART(void);
22 void UART0_Transmit_DMA(int);
23 void TransmitBufferCreate(void); 24 void UART1_Transmit(int value); 25 void UART0_Transmit_OneByte(void); 26 void Init_UART1(void);
27
28
29 extern uint8_t transmitbuffer[11]; 30 extern int shiftedpinky;
31 extern int shiftedring;
32 extern int shiftedmiddle;
33 extern int shiftedindex; 34 extern int shiftedthumb; 35 //extern uint8_t cal_val; 36
37 #endif
38
39 //Note: added ifndef and endif to get rid of "include nested too deeply" 40 //error
41

Code for Mode detect source file 1 #include"read.h"
2
3 uint8_t cal_val;
4 //cal_val = 0 indicates performance mode
5 //cal_val = 1 indicates calibration of standing up 6 //cal_val = 2 indicates calibration of bent position 7
8 void Init_CAL_GPIO(void){
9
10 // Test code to see if ADC works
11 // Enable clocks
12 SIM->SCGC5 |= SIM_SCGC5_PORTA_MASK | SIM_SCGC5_PORTB_MASK ;
13
14
15 //Select GPIO pin for 6 LED outputs
16 PORTB->PCR[CAL_LED_1] &= ~PORT_PCR_MUX_MASK; 17 PORTB->PCR[CAL_LED_1] |= PORT_PCR_MUX(1); 18 PORTB->PCR[CAL_LED_2] &= ~PORT_PCR_MUX_MASK; 19 PORTB->PCR[CAL_LED_2] |= PORT_PCR_MUX(1); 20 PORTA->PCR[CAL_SW] &= ~PORT_PCR_MUX_MASK; 21 PORTA->PCR[CAL_SW] |= PORT_PCR_MUX(1);
22
23 //set LED bits as outputs
24 PTB->PDDR |= MASK(CAL_LED_1) | MASK(CAL_LED_2);
25
26 //Set sw as input
27 PTA->PDDR &= ~MASK(CAL_SW);
28
29 //Switch off all LEDS intially

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
R |=

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
Code for main source file on Transmission MCU 1 #include "main.h"

4 int index = 0;

6 int main(void){

adc_init();
Init_UART();
10 dma_init();
11 pit_init();
12 Init_CAL_GPIO();
13 Init_UART1();

15 while(1)
16 {
//UART0_Transmit_OneByte(); Read_Switches();
Light_LED();
if(while_flag == 1)
{
TransmitBufferCreate();

while(while_flag)
{

UART0->C2 |= UART0_C2_TE_MASK; UART1->C2 |= UART_C2_TE_MASK; if (index < 11)
{
UART1_Transmit(1);
UART0_Transmit_DMA(index);
}
index++;
if(index > 11) //if you change 11 to a 10, the uart might be on the cusp of sending/not sending //11 gives the uart plenty of time to reset the index, etc.
{
UART1_Transmit(0);
UART0->C2 &= ~UART0_C2_TE_MASK; //disable interrupt once all values are transferred UART1->C2 &= ~UART_C2_TE_MASK;
index = 0;
while_flag = 0; //stops while loop conversion_done = 0;
}
}
}
47 }

48
49 }
50

Code for main header file on Transmission MCU

1 #include "pit.h"
2 #include "dma.h"
3 #include "adc.h"
4 #include "read.h"
5 #include <MKL25Z4.h>
6

Code for UART RX source file 1 #include "UART.h"
2
3 //UART RX
4 uint8_t receivedbuffer[11];
5 uint16_t receivedADCread[5];
6 uint8_t receivedcal_val;
7 volatile int received_go_signal = 0; 8 volatile int raise_this_flag = 0; 9
10
11
12
13 void Init_UART(void)
14 {
15 // Let's use UART0 and PTA
16 // Enable clock gating for UART0 and Port A 17
18 uint16_t sbr;
19
20 //We use Receive data from glove and maybe eventually Transmit (for error check)
21 //Since the UART can only take 8 bits, and we have 5 important 16 bit values that
22 //need to be sent, we would have to fill D reg with each half of an array element
23 //making it a total of 5*2 times D needs to be updated.
24 SIM->SCGC4 |= SIM_SCGC4_UART0_MASK;
25 SIM->SCGC5 |= SIM_SCGC5_PORTE_MASK;
26
27 // Make sure transmitter and receiver are disabled before configuring 28 UART0->C2 &= ~UART_C2_TE_MASK & ~UART_C2_RE_MASK;
29
30 // UART 1 has to use Bus Clock, clock can't be configured
31 // according to table 5-2 (page 122) of reference manual
32 // and absence of macors
33 // but UART0 clock needs to be set - to 48 MHz clock in this case 34 SIM->SOPT2 |= SIM_SOPT2_UART0SRC(1);
35 //SIM->SOPT2 |= SIM_SOPT2_PLLFLLSEL_MASK;
36

37 // Set pins to UART1 Rx and Tx
38 PORTE->PCR[RX_PIN] |= PORT_PCR_MUX(4); // Rx
39
40 // Set baud rate and oversampling ratio
41 sbr = (uint16_t)((CLOCK)/(BAUD_RATE * OVERSAMPLE_RATE)) - 32; 42 UART0->BDH &= ~UART0_BDH_SBR_MASK;
43 UART0->BDH |= UART0_BDH_SBR(0x1F & (sbr>>8));
44 UART0->BDL = UART0_BDL_SBR(sbr);
45 UART0->C4 |= UART0_C4_OSR(OVERSAMPLE_RATE-1); //UARTLP_C4_OSR(x) is same as UART1_C4_OSR(x) and since C4 reg all UART is same, it should work
46
47 //LIN break is high whenever a break is detected.
48 //I believe this occurs when there is empty space in a transmission or recieve line
49 //this will set LBKDIF bit in UARTx_S2 as a high.
50 //setting LBKDIE bit in BDH reg will cause an interrupt if LBKDIF is high 51 UART0->BDH |= UART0_BDH_LBKDIE(0); // for now let's disable it
52 UART0->BDH |= UART0_BDH_RXEDGIE(0); // Disable interrupts for RX active edge
53 UART0->BDH |= UART0_BDH_SBNS(0); // one stop-bit - only two options 1 or 2
54 | // Its
logic level is the same as the signal's idle state, i.e., logic high
55 UART0->C1 |= UART0_C1_M(0); //Data bit mode - 8 bits - In 8-bit data mode, the shift register holds a
56 | //start bit, eight
data bits, and a stop bit.
57 UART0->C1 |= UART0_C1_LOOPS(0); //0: Normal operation - RxD and TxD use separate pins.
58 UART0->C1 | |= UART0_C1_PE(0); //Don't use parity bit
59 | //We can use
parity bit but will need to change bit mode to 9 - The 9-bit data mode is typically used with parity to allow eight bits of data plus the parity in the ninth bit
60 | //When parity
is enabled, the bit immediately before the stop bit is treated as the parity bit
61 | // a little
confused about D being only 8 bits long
62 | // will also
need to set PT bit in C1 to parity odd or even and enable interrupt for parity (PEIE) in C3
63
64 // Don't enable interrupts for errors
65 UART0->C3 = UART0_C3_ORIE(0)| UART0_C3_NEIE(0) | UART0_C3_FEIE(0) |
UART0_C3_PEIE(0);
66
67 // Clear error flags
68 UART0->S1 |= UART0_S1_OR(1) | UART0_S1_NF(1) | UART0_S1_FE(1) |
UART0_S1_PF(1); //To clear these flags write logic one to them
69
70 UART0->S2 = UART0_S2_MSBF(0) | UART0_S2_RXINV(0); //Send LSB first, do
not invert received data

71
72 UART0->C2 |= UART_C2_RE(1); // Enable UART receiver 73
74
75 }
76
77
78 void Init_UART1(void)
79 {
80 // rx pin (PTC3)
81
82 uint16_t sbr;
83
84 SIM->SCGC4 |= SIM_SCGC4_UART1_MASK;
85 SIM->SCGC5 |= SIM_SCGC5_PORTC_MASK;
86
87 UART1->C2 &= ~UART_C2_TE_MASK & ~UART_C2_RE_MASK;
88
89 PORTC->PCR[3] |= PORT_PCR_MUX(3); //3 is the RX pin for UART1; alternative 3 is the selection option for UART1 rx
90
91 sbr = (uint16_t)((CLOCK)/(BAUD_RATE * 16)) - 32;
92 UART1->BDH &= ~UART_BDH_SBR_MASK;
93 UART1->BDH |= UART_BDH_SBR(0x1F & (sbr>>8)); 94 UART1->BDL = UART_BDL_SBR(sbr);
95 //UART1->C4 |= UARTLP_C4_OSR(OVERSAMPLE_RATE-1); 96
97 UART1->BDH |= UART_BDH_LBKDIE(0);
98 UART1->BDH |= UART_BDH_RXEDGIE(0);
99 UART1->BDH |= UART_BDH_SBNS(0); 100
101
102 | UART1->C1 |= UART_C1_M(0);
103 | UART1->C1 |= UART_C1_LOOPS(0);
104 | UART1->C1 | |= UART_C1_PE(0);
105
106 UART1->C3 = UART_C3_ORIE(0)| UART_C3_NEIE(0) | UART_C3_FEIE(0) |
UART_C3_PEIE(0);
107
108 | UART1->S2 &= ~UARTLP_S2_MSBF_MASK;
109 | UART1 -> S2 = UART_S2_RXINV(0);
110 | UART1->C2 |= UART_C2_RE(1) | UART_C2_RIE(1);
111
112 | NVIC_SetPriority(UART1_IRQn, 0);
113 | NVIC_ClearPendingIRQ(UART1_IRQn);
114 | NVIC_EnableIRQ(UART1_IRQn);
115 | __enable_irq();
116 }
117
118
119
120 void UART1_IRQHandler(void) 121 {

122
123 | if((UART1 -> S1) & (UART_S1_RDRF_MASK))
124 | {
125 | received_go_signal = UART1 -> D;
126 | if(received_go_signal)
127 | raise_this_flag = 1;
128 | else
129 | raise_this_flag = 0;
130 | }
131
132 }
133
134
135
136
137
138
139 void UART0_Receive_DMA(int index) {
140
141
142 | while (!(UART0->S1 & UART0_S1_RDRF_MASK));
143
144 | receivedbuffer[index] = UART0->D;
145
146 }
147
148 void CombineReceiveBuffer(){
149
150 receivedADCread[pinky_index] = COMBINE(receivedbuffer[1], receivedbuffer[0]);
151 | receivedADCread[ring_index] = | COMBINE(receivedbuffer[3],
receivedbuffer[2]);
152 receivedADCread[middle_index] = COMBINE(receivedbuffer[5], receivedbuffer[4]);
153 receivedADCread[index_index] = COMBINE(receivedbuffer[7], receivedbuffer[6]);
154 receivedADCread[thumb_index] = COMBINE(receivedbuffer[9], receivedbuffer[8]);
155 receivedcal_val = receivedbuffer[10];
156 }
157
158
159 void UART0_Receive_char (void)
160 {
161 | while (!(UART0->S1 & UART0_S1_RDRF_MASK));
162 | //Receive_Done = UART0->D;
163 }

Code for UART RX header file
1 #include <MKL25Z4.h>
2 #include "dma.h"
3
4

5 #define BAUD_RATE (9600)
6 #define OVERSAMPLE_RATE (25) 7 #define CLOCK (24000000)
8
9
10 #define RX_PIN 21 //on port E - ALT 4 is UART0_Rx 11
12 #define LSB(x) (uint8_t)(x & 0x00FF)
13 #define MSB(x) (uint8_t)((x & 0xFF00) >> 8)
14 #define COMBINE(MSB, LSB) (uint16_t)(((uint16_t)MSB << 8) | LSB)
15
16 void Init_UART(void);
17 void UART0_Receive_DMA(int);
18 void CombineReceiveBuffer(void); 19 void UART0_Receive_char (void); 20 void Init_UART1(void);
21
22 extern uint8_t receivedbuffer[11];
23 extern uint16_t receivedADCread[5]; 24 extern uint8_t receivedcal_val;
25 extern volatile int received_go_signal; 26 extern volatile int raise_this_flag; Code for calibration and letter decode source file

1 #include "cal.h"
2 #include "UART.h"
3 //uint16_t receivedADCread[5];
4 //uint8_t receivedcal_val;
5 uint16_t Observed_Standing_values[5] = {0xFFFF, 0xF800, 0xFFFF, 0xFFFF, 0xCB00};
6 uint16_t Observed_Bent_values[5] = {0x5100, 0x0120, 0xAE00, 0xAF00, 0x6800};
7 uint32_t Standing_Ranges[10] = {0,0,0,0,0,0,0,0,0,0};
8 uint32_t Bent_Ranges[10] = {0,0,0,0,0,0,0,0,0,0};
9 uint32_t Middle_Ranges[10] = {0,0,0,0,0,0,0,0,0,0}; 10 uint16_t LUT[26][5];
11 uint16_t counterstand = 0;
12 uint16_t counterbend = 0;
13 int pinky_flag, ring_flag, middle_flag, index_flag, thumb_flag; 14 //flag = 0: standing
15 //flag = 1: middle
16 //flag = 2: bent
17 //cal_val = 0 indicates performance mode
18 //cal_val = 1 indicates calibration of standing up 19 //cal_val = 2 indicates calibration of bent position 20
21 void ranges(void)
22 {
23 if (receivedcal_val > 0)
24 {
25 | if (receivedcal_val == 1)
26 | {
27 | Standing_Ranges[pinky_LB] += receivedADCread[pinky_index];

28 | Standing_Ranges[pinky_UB] =
Observed_Standing_values[pinky_index];
29 | Standing_Ranges[ring_LB] | += receivedADCread[ring_index];
30 | Standing_Ranges[ring_UB] | =
Observed_Standing_values[ring_index];
31 | Standing_Ranges[middle_LB] += receivedADCread[middle_index];
32 | Standing_Ranges[middle_UB] =
Observed_Standing_values[middle_index];
33 | Standing_Ranges[index_LB] += receivedADCread[index_index];
//lol
34 | Standing_Ranges[index_UB] =
Observed_Standing_values[index_index];
35 | Standing_Ranges[thumb_LB] += receivedADCread[thumb_index];
36 | Standing_Ranges[thumb_UB] =
Observed_Standing_values[thumb_index];
37 | counterstand++;
38 | }
39 | if (receivedcal_val == 2)
40 | {
41 | Bent_Ranges[pinky_LB] += receivedADCread[pinky_index];
42 | Bent_Ranges[pinky_UB] = Observed_Bent_values[pinky_index];
43 | Bent_Ranges[ring_LB] | += receivedADCread[ring_index];
44 | Bent_Ranges[ring_UB] | = Observed_Bent_values[ring_index];
45 | Bent_Ranges[middle_LB] += receivedADCread[middle_index];
46 | Bent_Ranges[middle_UB] = Observed_Bent_values[middle_index];
47 | Bent_Ranges[index_LB] += receivedADCread[index_index]; //lol
48 | Bent_Ranges[index_UB] = Observed_Bent_values[index_index];
49 | Bent_Ranges[thumb_LB] += receivedADCread[thumb_index];
50 | Bent_Ranges[thumb_UB] = Observed_Bent_values[thumb_index];
51 | counterbend++;
52 | }
53 | /*
54 | for (int i = 0; i < 10; i++)
55 | {
56 | Standing_Ranges[i] = Standing_Ranges[i]/counterstand;
57 | Bent_Ranges[i] = Bent_Ranges[i]/counterbend;
58 | }
59 | counterstand = 0;
60 | counterbend = 0;
61 | for (int i = 0; i < 10; i=i+2)
62 | {
63 | uint16_t min = Min(Standing_Ranges[i], Standing_Ranges[i+1]);
64 | uint16_t max = Max(Standing_Ranges[i], Standing_Ranges[i+1]);
65 | Standing_Ranges[i] = min;
66 | Standing_Ranges[i+1] = max;
67 | min = Min(Bent_Ranges[i], Bent_Ranges[i+1]);
68 | max = Max(Bent_Ranges[i], Bent_Ranges[i+1]);
69 | Bent_Ranges[i] = min;
70 | Bent_Ranges[i+1] = max;
71 | }
72
73 | Middle_Ranges[pinky_LB] = (Standing_Ranges[pinky_LB] +
Bent_Ranges[pinky_LB])/2;

74 | Middle_Ranges[pinky_UB] = (Standing_Ranges[pinky_UB] +
Bent_Ranges[pinky_UB])/2;
75 | Middle_Ranges[ring_LB] | = (Standing_Ranges[ring_LB] +
Bent_Ranges[ring_LB])/2;
76 | Middle_Ranges[ring_UB] | = (Standing_Ranges[ring_UB] +
Bent_Ranges[ring_UB])/2;
77 | Middle_Ranges[middle_LB] = (Standing_Ranges[middle_LB] +
Bent_Ranges[middle_LB])/2;
78 | Middle_Ranges[middle_UB] = (Standing_Ranges[middle_UB] +
Bent_Ranges[middle_UB])/2;
79 | Middle_Ranges[index_LB] = (Standing_Ranges[index_LB] +
Bent_Ranges[index_LB])/2;
80 | Middle_Ranges[index_UB] = (Standing_Ranges[index_UB] +
Bent_Ranges[index_UB])/2;
81 | Middle_Ranges[thumb_LB] = (Standing_Ranges[thumb_LB] +
Bent_Ranges[thumb_LB])/2;
82 | Middle_Ranges[thumb_UB] = (Standing_Ranges[thumb_UB] +
Bent_Ranges[thumb_UB])/2;*/
83 }
84 }
85
86 void AVG()
87 {
88 | for (int i = 0; i < 10; i= i+2)
89 | {
90 | if(counterstand != 0)
91 | Standing_Ranges[i] = Standing_Ranges[i]/counterstand;
92 | if(counterbend!=0)
93 | Bent_Ranges[i] = Bent_Ranges[i]/counterbend;
94 | }
95 | counterbend = 0;
96 | counterstand = 0;
97 | for (int i = 0; i < 10; i=i+2)
98 | {
99 | uint16_t min = Min(Standing_Ranges[i], Standing_Ranges[i+1]);
100 | uint16_t max = Max(Standing_Ranges[i],
Standing_Ranges[i+1]);
101 | Standing_Ranges[i] = min;
102 | Standing_Ranges[i+1] = max;
103 | min = Min(Bent_Ranges[i], Bent_Ranges[i+1]);
104 | max = Max(Bent_Ranges[i], Bent_Ranges[i+1]);
105 | Bent_Ranges[i] = min;
106 | Bent_Ranges[i+1] = max;
107 | }
108
109 | Middle_Ranges[pinky_LB] = (Standing_Ranges[pinky_LB] +
Bent_Ranges[pinky_LB])/2;
110 | Middle_Ranges[pinky_UB] = (Standing_Ranges[pinky_UB] +
Bent_Ranges[pinky_UB])/2;
111 | Middle_Ranges[ring_LB] | = (Standing_Ranges[ring_LB] +
Bent_Ranges[ring_LB])/2;
112 | Middle_Ranges[ring_UB] | = (Standing_Ranges[ring_UB] +
Bent_Ranges[ring_UB])/2;

113 | Middle_Ranges[middle_LB] = (Standing_Ranges[middle_LB] +
Bent_Ranges[middle_LB])/2;
114 | Middle_Ranges[middle_UB] = (Standing_Ranges[middle_UB] +
Bent_Ranges[middle_UB])/2;
115 | Middle_Ranges[index_LB] = (Standing_Ranges[index_LB] +
Bent_Ranges[index_LB])/2;
116 | Middle_Ranges[index_UB] = (Standing_Ranges[index_UB] +
Bent_Ranges[index_UB])/2;
117 | Middle_Ranges[thumb_LB] = (Standing_Ranges[thumb_LB] +
Bent_Ranges[thumb_LB])/2;
118 | Middle_Ranges[thumb_UB] = (Standing_Ranges[thumb_UB] +
Bent_Ranges[thumb_UB])/2;
119 }
120
121
122
123
124 void LUT_func(void){
125
126 | /*
127 | LUT[A][0][pinky_index] = Bent_Ranges[0];
128 | LUT[A][1][pinky_index] = Bent_Ranges[1];
129 | LUT[A][0][ring_index] = Bent_Ranges[1];
130 | LUT[A][1][ring_index] = Bent_Ranges[2];
131 | LUT[A][0][middle_index] = Bent_Ranges[3];
132 | LUT[A][1][middle_index] = Bent_Ranges[4];
133 | LUT[A][0][index_index] = Bent_Ranges[5];
134 | LUT[A][1][index_index] = Bent_Ranges[6];
135 | LUT[A][0][thumb_index] = Standing_Ranges[7];
136 | LUT[A][1][thumb_index] = Standing_Ranges[8];
137 | */
138 | //Determing positions of each finger - what flag to set for each
finger
139 //pinky
140
141
142 //LUT
143
144 | //Letter A - SAME AS T - use fsr.
145 | LUT[A][pinky_index] = bent;
146 | LUT[A][ring_index] | = bent;
147 | LUT[A][middle_index] = bent;
148 | LUT[A][index_index] = bent;
149 | LUT[A][thumb_index] = standing;
150
151 | //Letter B
152 | LUT[B][pinky_index] = standing;
153 | LUT[B][ring_index] | = standing;
154 | LUT[B][middle_index] = standing;
155 | LUT[B][index_index] = standing;
156 | LUT[B][thumb_index] = bent;
157
158 //Letter C

159 | LUT[C][pinky_index] = middle;
160 | LUT[C][ring_index] | = middle;
161 | LUT[C][middle_index] = middle;
162 | LUT[C][index_index] = middle;
163 | LUT[C][thumb_index] = middle;
164
165 | //Letter D
166 | LUT[D][pinky_index] = middle;
167 | LUT[D][ring_index] | = middle;
168 | LUT[D][middle_index] = middle;
169 | LUT[D][index_index] = standing;
170 | LUT[D][thumb_index] = middle;
171
172 | //Letter E
173 | LUT[E][pinky_index] = bent;
174 | LUT[E][ring_index] | = bent;
175 | LUT[E][middle_index] = bent;
176 | LUT[E][index_index] = bent;
177 | LUT[E][thumb_index] = bent;
178
179 | //Letter F
180 | LUT[F][pinky_index] = standing;
181 | LUT[F][ring_index] | = standing;
182 | LUT[F][middle_index] = standing;
183 | LUT[F][index_index] = middle;
184 | LUT[F][thumb_index] = middle;
185
186 | //Letter G
187 | //Note: thumb can be interpreted as middle or standing,
188 | //in our implementation it's middle
189 | LUT[G][pinky_index] = bent;
190 | LUT[G][ring_index] | = bent;
191 | LUT[G][middle_index] = bent;
192 | LUT[G][index_index] = standing;
193 | LUT[G][thumb_index] = middle;
194
195 | //Letter H
196 | LUT[H][pinky_index] = bent;
197 | LUT[H][ring_index] | = bent;
198 | LUT[H][middle_index] = standing;
199 | LUT[H][index_index] = standing;
200 | LUT[H][thumb_index] = middle;
201
202 | //Letter I
203 | LUT[I][pinky_index] = standing;
204 | LUT[I][ring_index] | = bent;
205 | LUT[I][middle_index] = bent;
206 | LUT[I][index_index] = bent;
207 | LUT[I][thumb_index] = bent;
208
209 | //Letter J
210 | LUT[J][pinky_index] = standing;
211 | LUT[J][ring_index] | = bent;

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
E!!!!!!!! 231 | LUT[M][pinky_index] = bent; 232 | LUT[M][ring_index] | = bent; 233 | LUT[M][middle_index] = bent; 234 | LUT[M][index_index] = bent; 235 | LUT[M][thumb_index] = bent; 236 237 | //Letter N //SAME AS S!!!!!!!! 238 | LUT[N][pinky_index] = bent; 239 | LUT[N][ring_index] | = bent; 240 | LUT[N][middle_index] = bent; 241 | LUT[N][index_index] = bent; 242 | LUT[N][thumb_index] = middle; 243 244 | //Letter O 245 | LUT[O][pinky_index] = middle; 246 | LUT[O][ring_index] | = middle; 247 | LUT[O][middle_index] = middle; 248 | LUT[O][index_index] = middle; 249 | LUT[O][thumb_index] = middle; 250 251 | //Letter P 252 | LUT[P][pinky_index] = bent; 253 | LUT[P][ring_index] | = bent; 254 | LUT[P][middle_index] = middle; 255 | LUT[P][index_index] = standin

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
K!!! 287 LUT[U][pinky_index] = be n

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
K!!!! 294 LUT[V][pinky_index] = ben t

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
318 | LUT[Y][index_index] = middle;
319 | LUT[Y][thumb_index] = bent;
320
321 | //Letter Z
322 | LUT[Z][pinky_index] = bent;
323 | LUT[Z][ring_index] | = bent;
324 | LUT[Z][middle_index] = bent;
325 | LUT[Z][index_index] = standing;
326 | LUT[Z][thumb_index] = bent;
327
328 }
329
330 //this function returns 0-25, indicating A-Z which will be used as input to screen
331 int letter_decode(void)
332 {
333 | int bent_middle_mid_point;
334 | int stand_middle_mid_point;
335 | if(receivedADCread[pinky_index] >= Bent_Ranges[pinky_LB] &&
receivedADCread[pinky_index] <= Bent_Ranges[pinky_UB])
336 | pinky_flag = bent;
337 | else if(receivedADCread[pinky_index] >= Middle_Ranges[pinky_LB] &&
receivedADCread[pinky_index] <= Middle_Ranges[pinky_UB])
338 | pinky_flag = middle;
339 | else if(receivedADCread[pinky_index] >= Standing_Ranges[pinky_LB] &&
receivedADCread[pinky_index] <= Standing_Ranges[pinky_UB])
340 | pinky_flag = standing;
341 | else if (receivedADCread[pinky_index] < Bent_Ranges[pinky_LB])
342 | pinky_flag = bent;
343 | else if (receivedADCread[pinky_index] > Standing_Ranges[pinky_UB])
344 | pinky_flag = standing;
345 | else
346 | {
347 | bent_middle_mid_point = (Bent_Ranges[pinky_UB] +
Middle_Ranges[pinky_LB])/2;
348 | stand_middle_mid_point = (Middle_Ranges[pinky_UB] +
Standing_Ranges[pinky_LB])/2;
349 | if (receivedADCread[pinky_index] < Standing_Ranges[pinky_LB] &&
receivedADCread[pinky_index] > stand_middle_mid_point)
350 | pinky_flag = standing;
351 | if (receivedADCread[pinky_index] > Middle_Ranges[pinky_LB] &&
receivedADCread[pinky_index] < stand_middle_mid_point)
352 | pinky_flag = middle;
353 | if (receivedADCread[pinky_index] < Middle_Ranges[pinky_LB] &&
receivedADCread[pinky_index] > bent_middle_mid_point)
354 | pinky_flag = middle;
355 | if (receivedADCread[pinky_index] > Bent_Ranges[pinky_UB] &&
receivedADCread[pinky_index] < bent_middle_mid_point)
356 | pinky_flag = bent;
357 | }
358
359 //ring

360 if(receivedADCread[ring_index] >= Bent_Ranges[ring_LB] && receivedADCread[ring_index] <= Bent_Ranges[ring_UB])
361 | ring_flag = bent;
362 | else if(receivedADCread[ring_index] >= Middle_Ranges[ring_LB] &&
receivedADCread[ring_index] <= Middle_Ranges[ring_UB])
363 | ring_flag = middle;
364 | else if(receivedADCread[ring_index] >= Standing_Ranges[ring_LB] &&
receivedADCread[ring_index] <= Standing_Ranges[ring_UB])
365 | ring_flag = standing;
366 | else if (receivedADCread[ring_index] < Bent_Ranges[ring_LB])
367 | ring_flag = bent;
368 | else if (receivedADCread[ring_index] > Standing_Ranges[ring_UB])
369 | ring_flag = standing;
370 | else
371 | {
372 | bent_middle_mid_point = (Bent_Ranges[ring_UB] +
Middle_Ranges[ring_LB])/2;
373 | stand_middle_mid_point = (Middle_Ranges[ring_UB] +
Standing_Ranges[ring_LB])/2;
374 | if (receivedADCread[ring_index] < Standing_Ranges[ring_LB] &&
receivedADCread[ring_index] > stand_middle_mid_point)
375 | ring_flag = standing;
376 | if (receivedADCread[ring_index] > Middle_Ranges[ring_LB] &&
receivedADCread[ring_index] < stand_middle_mid_point)
377 | ring_flag = middle;
378 | if (receivedADCread[ring_index] < Middle_Ranges[ring_LB] &&
receivedADCread[ring_index] > bent_middle_mid_point)
379 | ring_flag = middle;
380 | if (receivedADCread[ring_index] > Bent_Ranges[ring_UB] &&
receivedADCread[ring_index] < bent_middle_mid_point)
381 | ring_flag = bent;
382 | }
383
384 | //middle
385 | if(receivedADCread[middle_index] >= Bent_Ranges[middle_LB] &&
receivedADCread[middle_index] <= Bent_Ranges[middle_UB])
386 | middle_flag = bent;
387 | else if(receivedADCread[middle_index] >= Middle_Ranges[middle_LB] &&
receivedADCread[middle_index] <= Middle_Ranges[middle_UB])
388 | middle_flag = middle;
389 | else if(receivedADCread[middle_index] >= Standing_Ranges[middle_LB]
&& receivedADCread[middle_index] <= Standing_Ranges[middle_UB])
390 | middle_flag = standing;
391 | else if (receivedADCread[middle_index] < Bent_Ranges[middle_LB])
392 | middle_flag = bent;
393 | else if (receivedADCread[middle_index] >
Standing_Ranges[middle_UB])
394 | middle_flag = standing;
395 | else
396 | {
397 | bent_middle_mid_point = (Bent_Ranges[middle_UB] +
Middle_Ranges[middle_LB])/2;

398 | stand_middle_mid_point = (Middle_Ranges[middle_UB] +
Standing_Ranges[middle_LB])/2;
399 | if (receivedADCread[middle_index] < Standing_Ranges[middle_LB]
&& receivedADCread[middle_index] > stand_middle_mid_point)
400 | middle_flag = standing;
401 | if (receivedADCread[middle_index] > Middle_Ranges[middle_LB] &&
receivedADCread[middle_index] < stand_middle_mid_point)
402 | middle_flag = middle;
403 | if (receivedADCread[middle_index] < Middle_Ranges[middle_LB] &&
receivedADCread[middle_index] > bent_middle_mid_point)
404 | middle_flag = middle;
405 | if (receivedADCread[middle_index] > Bent_Ranges[middle_UB] &&
receivedADCread[middle_index] < bent_middle_mid_point)
406 | middle_flag = bent;
407 | }
408
409 | //index
410 | if(receivedADCread[index_index] >= Bent_Ranges[index_LB] &&
receivedADCread[index_index] <= Bent_Ranges[index_UB])
411 | index_flag = bent;
412 | else if(receivedADCread[index_index] >= Middle_Ranges[index_LB] &&
receivedADCread[index_index] <= Middle_Ranges[index_UB])
413 | index_flag = middle;
414 | else if(receivedADCread[index_index] >= Standing_Ranges[index_LB] &&
receivedADCread[index_index] <= Standing_Ranges[index_UB])
415 | index_flag = standing;
416 | else if (receivedADCread[index_index] < Bent_Ranges[index_LB])
417 | index_flag = bent;
418 | else if (receivedADCread[index_index] > Standing_Ranges[index_UB])
419 | index_flag = standing;
420 | else
421 | {
422 | bent_middle_mid_point = (Bent_Ranges[index_UB] +
Middle_Ranges[index_LB])/2;
423 | stand_middle_mid_point = (Middle_Ranges[index_UB] +
Standing_Ranges[index_LB])/2;
424 | if (receivedADCread[index_index] < Standing_Ranges[index_LB] &&
receivedADCread[index_index] > stand_middle_mid_point)
425 | index_flag = standing;
426 | if (receivedADCread[index_index] > Middle_Ranges[index_LB] &&
receivedADCread[index_index] < stand_middle_mid_point)
427 | index_flag = middle;
428 | if (receivedADCread[index_index] < Middle_Ranges[index_LB] &&
receivedADCread[index_index] > bent_middle_mid_point)
429 | index_flag = middle;
430 | if (receivedADCread[index_index] > Bent_Ranges[index_UB] &&
receivedADCread[index_index] < bent_middle_mid_point)
431 | index_flag = bent;
432 | }
433
434 | //thumb
435 | if(receivedADCread[thumb_index] >= Bent_Ranges[thumb_LB] &&
receivedADCread[thumb_index] <= Bent_Ranges[thumb_UB])

436 | thumb_flag = bent;
437 | else if(receivedADCread[thumb_index] >= Middle_Ranges[thumb_LB] &&
receivedADCread[thumb_index] <= Middle_Ranges[thumb_UB])
438 | thumb_flag = middle;
439 | else if(receivedADCread[thumb_index] >= Standing_Ranges[thumb_LB] &&
receivedADCread[thumb_index] <= Standing_Ranges[thumb_UB])
440 | thumb_flag = standing;
441 | else if (receivedADCread[thumb_index] < Bent_Ranges[thumb_LB])
442 | thumb_flag = bent;
443 | else if (receivedADCread[thumb_index] > Standing_Ranges[thumb_UB])
444 | thumb_flag = standing;
445 | else
446 | {
447 | bent_middle_mid_point = (Bent_Ranges[thumb_UB] +
Middle_Ranges[thumb_LB])/2;
448 | stand_middle_mid_point = (Middle_Ranges[thumb_UB] +
Standing_Ranges[thumb_LB])/2;
449 | if (receivedADCread[thumb_index] < Standing_Ranges[thumb_LB] &&
receivedADCread[thumb_index] > stand_middle_mid_point)
450 | thumb_flag = standing;
451 | if (receivedADCread[thumb_index] > Middle_Ranges[thumb_LB] &&
receivedADCread[thumb_index] < stand_middle_mid_point)
452 | thumb_flag = middle;
453 | if (receivedADCread[thumb_index] < Middle_Ranges[thumb_LB] &&
receivedADCread[thumb_index] > bent_middle_mid_point)
454 | thumb_flag = middle;
455 | if (receivedADCread[thumb_index] > Bent_Ranges[thumb_UB] &&
receivedADCread[thumb_index] < bent_middle_mid_point)
456 | thumb_flag = bent;
457 | }
458
459
460 | //Letter A - 0
461 | if ((pinky_flag == LUT[A][pinky_index]) && (ring_flag ==
LUT[A][ring_index]) && (middle_flag == LUT[A][middle_index]) && (index_flag == LUT[A][index_index]) && (thumb_flag == LUT[A][thumb_index]))
462 | {
463 | return A;
464 | }
465
466 | //Letter B - 1
467 | if ((pinky_flag == LUT[B][pinky_index]) && (ring_flag ==
LUT[B][ring_index]) && (middle_flag == LUT[B][middle_index]) && (index_flag == LUT[B][index_index]) && (thumb_flag == LUT[B][thumb_index]))
468 | {
469 | return B;
470 | }
471
472 | //Letter C - 2
473 | if ((pinky_flag == LUT[C][pinky_index]) && (ring_flag ==
LUT[C][ring_index]) && (middle_flag == LUT[C][middle_index]) && (index_flag == LUT[C][index_index]) && (thumb_flag == LUT[C][thumb_index]))
474 {

475 | return C;
476 | }
477
478 | //Letter D - 3
479 | if ((pinky_flag == LUT[D][pinky_index]) && (ring_flag ==
LUT[D][ring_index]) && (middle_flag == LUT[D][middle_index]) && (index_flag == LUT[D][index_index]) && (thumb_flag == LUT[D][thumb_index]))
480 | {
481 | return D;
482 | }
483
484 | //Letter E - 4
485 | if ((pinky_flag == LUT[E][pinky_index]) && (ring_flag ==
LUT[E][ring_index]) && (middle_flag == LUT[E][middle_index]) && (index_flag == LUT[E][index_index]) && (thumb_flag == LUT[E][thumb_index]))
486 | {
487 | return E;
488 | }
489
490 | //Letter F - 5
491 | if ((pinky_flag == LUT[F][pinky_index]) && (ring_flag ==
LUT[F][ring_index]) && (middle_flag == LUT[F][middle_index]) && (index_flag == LUT[F][index_index]) && (thumb_flag == LUT[F][thumb_index]))
492 | {
493 | return F;
494 | }
495
496 | //Letter G - 6
497 | if ((pinky_flag == LUT[G][pinky_index]) && (ring_flag ==
LUT[G][ring_index]) && (middle_flag == LUT[G][middle_index]) && (index_flag == LUT[G][index_index]) && (thumb_flag == LUT[G][thumb_index]))
498 | {
499 | return G;
500 | }
501
502 | //Letter H - 7
503 | if ((pinky_flag == LUT[H][pinky_index]) && (ring_flag ==
LUT[H][ring_index]) && (middle_flag == LUT[H][middle_index]) && (index_flag == LUT[H][index_index]) && (thumb_flag == LUT[H][thumb_index]))
504 | {
505 | return H;
506 | }
507
508 | //Letter I - 8
509 | if ((pinky_flag == LUT[I][pinky_index]) && (ring_flag ==
LUT[I][ring_index]) && (middle_flag == LUT[I][middle_index]) && (index_flag == LUT[I][index_index]) && (thumb_flag == LUT[I][thumb_index]))
510 | {
511 | return I;
512 | }
513
514 //Letter J - 9

515 if ((pinky_flag == LUT[J][pinky_index]) && (ring_flag == LUT[J][ring_index]) && (middle_flag == LUT[J][middle_index]) && (index_flag == LUT[J][index_index]) && (thumb_flag == LUT[J][thumb_index]))
516 | {
517 | return J;
518 | }
519
520 | //Letter K - 10
521 | if ((pinky_flag == LUT[K][pinky_index]) && (ring_flag ==
LUT[K][ring_index]) && (middle_flag == LUT[K][middle_index]) && (index_flag == LUT[K][index_index]) && (thumb_flag == LUT[K][thumb_index]))
522 | {
523 | return K;
524 | }
525
526 | //Letter L - 11
527 | if ((pinky_flag == LUT[L][pinky_index]) && (ring_flag ==
LUT[L][ring_index]) && (middle_flag == LUT[L][middle_index]) && (index_flag == LUT[L][index_index]) && (thumb_flag == LUT[L][thumb_index]))
528 | {
529 | return L;
530 | }
531
532 | //Letter M - 12
533 | if ((pinky_flag == LUT[M][pinky_index]) && (ring_flag ==
LUT[M][ring_index]) && (middle_flag == LUT[M][middle_index]) && (index_flag == LUT[M][index_index]) && (thumb_flag == LUT[M][thumb_index]))
534 | {
535 | return M;
536 | }
537
538 | //Letter N - 13
539 | if ((pinky_flag == LUT[N][pinky_index]) && (ring_flag ==
LUT[N][ring_index]) && (middle_flag == LUT[N][middle_index]) && (index_flag == LUT[N][index_index]) && (thumb_flag == LUT[N][thumb_index]))
540 | {
541 | return N;
542 | }
543
544 | //Letter O - 14
545 | if ((pinky_flag == LUT[O][pinky_index]) && (ring_flag ==
LUT[O][ring_index]) && (middle_flag == LUT[O][middle_index]) && (index_flag == LUT[O][index_index]) && (thumb_flag == LUT[O][thumb_index]))
546 | {
547 | return O;
548 | }
549
550 | //Letter P - 15
551 | if ((pinky_flag == LUT[P][pinky_index]) && (ring_flag ==
LUT[P][ring_index]) && (middle_flag == LUT[P][middle_index]) && (index_flag == LUT[P][index_index]) && (thumb_flag == LUT[P][thumb_index]))
552 | {
553 | return P;

554 }
555
556 | //Letter Q - 16
557 | if ((pinky_flag == LUT[Q][pinky_index]) && (ring_flag ==
LUT[Q][ring_index]) && (middle_flag == LUT[Q][middle_index]) && (index_flag == LUT[Q][index_index]) && (thumb_flag == LUT[Q][thumb_index]))
558 | {
559 | return Q;
560 | }
561
562 | //Letter R - 17
563 | if ((pinky_flag == LUT[R][pinky_index]) && (ring_flag ==
LUT[R][ring_index]) && (middle_flag == LUT[R][middle_index]) && (index_flag == LUT[R][index_index]) && (thumb_flag == LUT[R][thumb_index]))
564 | {
565 | return R;
566 | }
567
568 | //Letter S - 18
569 | if ((pinky_flag == LUT[S][pinky_index]) && (ring_flag ==
LUT[S][ring_index]) && (middle_flag == LUT[S][middle_index]) && (index_flag == LUT[S][index_index]) && (thumb_flag == LUT[S][thumb_index]))
570 | {
571 | return S;
572 | }
573
574 | //Letter T - 19
575 | if ((pinky_flag == LUT[T][pinky_index]) && (ring_flag ==
LUT[T][ring_index]) && (middle_flag == LUT[T][middle_index]) && (index_flag == LUT[T][index_index]) && (thumb_flag == LUT[T][thumb_index]))
576 | {
577 | return T;
578 | }
579
580 | //Letter U - 20
581 | if ((pinky_flag == LUT[U][pinky_index]) && (ring_flag ==
LUT[U][ring_index]) && (middle_flag == LUT[U][middle_index]) && (index_flag == LUT[U][index_index]) && (thumb_flag == LUT[U][thumb_index]))
582 | {
583 | return U;
584 | }
585
586 | //Letter V - 21
587 | if ((pinky_flag == LUT[V][pinky_index]) && (ring_flag ==
LUT[V][ring_index]) && (middle_flag == LUT[V][middle_index]) && (index_flag == LUT[V][index_index]) && (thumb_flag == LUT[V][thumb_index]))
588 | {
589 | return V;
590 | }
591
592 //Letter W - 22

593 if ((pinky_flag == LUT[W][pinky_index]) && (ring_flag == LUT[W][ring_index]) && (middle_flag == LUT[W][middle_index]) && (index_flag == LUT[W][index_index]) && (thumb_flag == LUT[W][thumb_index]))
594 | {
595 | return W;
596 | }
597
598 | //Letter X - 23
599 | if ((pinky_flag == LUT[X][pinky_index]) && (ring_flag ==
LUT[X][ring_index]) && (middle_flag == LUT[X][middle_index]) && (index_flag == LUT[X][index_index]) && (thumb_flag == LUT[X][thumb_index]))
600 | {
601 | return X;
602 | }
603
604 | //Letter Y - 24
605 | if ((pinky_flag == LUT[Y][pinky_index]) && (ring_flag ==
LUT[Y][ring_index]) && (middle_flag == LUT[Y][middle_index]) && (index_flag == LUT[Y][index_index]) && (thumb_flag == LUT[Y][thumb_index]))
606 | {
607 | return Y;
608 | }
609
610 | //Letter Z - 25
611 | if ((pinky_flag == LUT[Z][pinky_index]) && (ring_flag ==
LUT[Z][ring_index]) && (middle_flag == LUT[Z][middle_index]) && (index_flag == LUT[Z][index_index]) && (thumb_flag == LUT[Z][thumb_index]))
612 | {
613 | return Z;
614 | }
615
616 return 26;
617 }
618
619 uint32_t Max(uint32_t num1, uint32_t num2) 620 {
621 | if (num1 >= num2)
622 | return num1;
623 | else
624 | return num2;
625 }
626
627 uint32_t Min(uint32_t num1, uint32_t num2) 628 {
629 | if (num1 <= num2)
630 | return num1;
631 | else
632 | return num2;
633 }

Code for calibration and letter decode header file

1 #include <MKL25Z4.h>

2 #include "UART.h"
3 #include "adc.h"
4 #include "dma.h"
5
6 #define A (0)
7 #define B (1)
8 #define C (2)
9 #define D (3)
10 #define E (4)
11 #define F (5)
12 #define G (6)
13 #define H (7)
14 #define I (8)
15 #define J (9)
16 #define K (10)
17 #define L (11)
18 #define M (12)
19 #define N (13)
20 #define O (14)
21 #define P (15)
22 #define Q (16)
23 #define R (17)
24 #define S (18)
25 #define T (19)
26 #define U (20)
27 #define V (21)
28 #define W (22)
29 #define X (23)
30 #define Y (24)
31 #define Z (25)
32
33 #define standing (0)
34 #define middle | (1)
35 #define bent | (2)
36
37 #define pinky_LB (0)
38 #define pinky_UB (1)
39 #define ring_LB | (2)
40 #define ring_UB | (3)
41 #define middle_LB (4)
42 #define middle_UB (5)
43 #define index_LB (6)
44 #define index_UB (7)
45 #define thumb_LB (8)
46 #define thumb_UB (9)
47
48 extern uint16_t Observed_Standing_values[5]; 49 extern uint16_t Observed_Bent_values[5]; 50 extern uint32_t Standing_Ranges[10];
51 extern uint32_t Bent_Ranges[10];
52 extern uint32_t Middle_Ranges[10];
53 extern uint16_t LUT[26][5];
54 extern int pinky_flag, ring_flag, middle_flag, index_flag, thumb_flag;

55 extern uint16_t receivedADCread[5]; 56 extern uint8_t receivedcal_val;
57 extern uint16_t counterstand;
58 extern uint16_t counterbend;
59 extern int in;
60
61 void ranges(void);
62 uint32_t Max(uint32_t num1, uint32_t num2); 63 uint32_t Min(uint32_t num1, uint32_t num2); 64 void LUT_func(void);
65 int letter_decode(void);
66 void AVG(void);

Code for 16 segment source file 1 #include "16Segment.h"
2 #include "cal.h"
3
4 int in;
5 void Init_14Segment(void){
6 //Enable Clock to port A and C
7 SIM_SCGC5 |= (SIM_SCGC5_PORTA_MASK | SIM_SCGC5_PORTC_MASK);
8 | PORTA->PCR[LED_A] &= ~PORT_PCR_MUX_MASK;
9 | PORTA->PCR[LED_A] |= PORT_PCR_MUX(1);
10 PORTA->PCR[LED_B] &= ~PORT_PCR_MUX_MASK;
11 PORTA->PCR[LED_B] |= PORT_PCR_MUX(1); 12 PORTA->PCR[LED_C] &= ~PORT_PCR_MUX_MASK; 13 PORTA->PCR[LED_C] |= PORT_PCR_MUX(1); 14 PORTA->PCR[LED_D] &= ~PORT_PCR_MUX_MASK; 15 PORTA->PCR[LED_D] |= PORT_PCR_MUX(1); 16 PORTA->PCR[LED_E] &= ~PORT_PCR_MUX_MASK; 17 PORTA->PCR[LED_E] |= PORT_PCR_MUX(1); 18 PORTA->PCR[LED_F] &= ~PORT_PCR_MUX_MASK; 19 PORTA->PCR[LED_F] |= PORT_PCR_MUX(1); 20 PORTA->PCR[LED_G] &= ~PORT_PCR_MUX_MASK; 21 PORTA->PCR[LED_G] |= PORT_PCR_MUX(1); 22 PORTC->PCR[LED_H] &= ~PORT_PCR_MUX_MASK; 23 PORTC->PCR[LED_H] |= PORT_PCR_MUX(1); 24 PORTC->PCR[LED_K] &= ~PORT_PCR_MUX_MASK; 25 PORTC->PCR[LED_K] |= PORT_PCR_MUX(1); 26 PORTC->PCR[LED_M] &= ~PORT_PCR_MUX_MASK; 27 PORTC->PCR[LED_M] |= PORT_PCR_MUX(1); 28 PORTC->PCR[LED_N] &= ~PORT_PCR_MUX_MASK; 29 PORTC->PCR[LED_N] |= PORT_PCR_MUX(1); 30 PORTC->PCR[LED_P] &= ~PORT_PCR_MUX_MASK; 31 PORTC->PCR[LED_P] |= PORT_PCR_MUX(1); 32 PORTC->PCR[LED_S] &= ~PORT_PCR_MUX_MASK; 33 PORTC->PCR[LED_S] |= PORT_PCR_MUX(1); 34 PORTC->PCR[LED_R] &= ~PORT_PCR_MUX_MASK; 35 PORTC->PCR[LED_R] |= PORT_PCR_MUX(1); 36 PORTC->PCR[LED_T] &= ~PORT_PCR_MUX_MASK; 37 PORTC->PCR[LED_T] |= PORT_PCR_MUX(1); 38 PORTC->PCR[LED_U] &= ~PORT_PCR_MUX_MASK; 39 PORTC->PCR[LED_U] |= PORT_PCR_MUX(1);

40
41 | //Set LED bits to outputs
42 PTA->PDDR |= MASK(LED_A) | MASK(LED_B) | MASK(LED_C) | MASK(LED_D) |
MASK(LED_E) | MASK(LED_F)| MASK(LED_G);
43 PTC->PDDR |= MASK(LED_H) | MASK(LED_K) | MASK(LED_M) | MASK(LED_N) |
MASK(LED_P) | MASK(LED_S)| MASK(LED_R) | MASK(LED_T)| MASK(LED_U);
44
45 //Turn off all LED's off initially
46 PTA->PSOR=MASK(LED_A);
47 PTA->PSOR=MASK(LED_B);
48 PTA->PSOR=MASK(LED_C);
49 PTA->PSOR=MASK(LED_D);
50 PTA->PSOR=MASK(LED_E);
51 PTA->PSOR=MASK(LED_F);
52 PTA->PSOR=MASK(LED_G);
53 PTC->PSOR=MASK(LED_H);
54 PTC->PSOR=MASK(LED_K);
55 PTC->PSOR=MASK(LED_M);
56 PTC->PSOR=MASK(LED_N);
57 PTC->PSOR=MASK(LED_P);
58 PTC->PSOR=MASK(LED_S);
59 PTC->PSOR=MASK(LED_R);
60 PTC->PSOR=MASK(LED_T);
61 PTC->PSOR=MASK(LED_U);
62 }
63
64 void control_LEDs(int A_on, int B_on, int C_on, int D_on, int E_on, int F_on, int G_on,int H_on, int K_on, int M_on, int N_on, int P_on, int S_on, int R_on, int T_on, int U_on)
65 {
66 if (A_on)
67 | PTA->PCOR = MASK(LED_A);
68 else
69 | PTA->PSOR = MASK(LED_A);
70 if (B_on)
71 | PTA->PCOR = MASK(LED_B);
72 else
73 | PTA->PSOR = MASK(LED_B);
74 if (C_on)
75 | PTA->PCOR = MASK(LED_C);
76 else
77 | PTA->PSOR = MASK(LED_C);
78 if (D_on)
79 | PTA->PCOR = MASK(LED_D);
80 else
81 | PTA->PSOR = MASK(LED_D);
82 if (E_on)
83 | PTA->PCOR = MASK(LED_E);
84 else
85 | PTA->PSOR = MASK(LED_E);
86 if (F_on)
87 | PTA->PCOR = MASK(LED_F);
88 else

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
4 #define LED_A (1) //on port A 5 #define LED_B (2) //on port A 6 #define LED_C (4) //on port A 7 #define LED_D (5) //on port A 8 #define LED_E (12) //on port A 9 #define LED_F (13) //on port A 10 #define LED_G (16) //on port A 11
12 #define LED_H (7)//on port C 13 #define LED_K (0)//on port C 14 #define LED_M (11)//on port C 15 #define LED_N (4) //on port C 16 #define LED_P (5)//on port C 17 #define LED_R (6) //on port C 18 #define LED_S (10)//on port C 19 #define LED_T (8) //on port C 20 #define LED_U (9)//on port C
21
22 void Init_14Segment(void);
23 void control_LEDs(int A_on, int B_on, int C_on, int D_on, int E_on, int F_on, int G_on,int H_on, int K_on, int M_on, int N_on, int P_on, int R_on, int S_on, int T_on, int U_on);
24 void Display_Alphabet(int input);
25

Code for main source file on Reception MCU
1 #include "main.h"
2
3 int ADC_is_reading_cal1 = 1000; //this flag is high till we are in cal = 1 mode
4 int ADC_is_reading_cal2 = 1000;
5 static int index = 0;
6 //uint16_t receivedADCread[5]= {0x0000,0x0002,0x0004,0x0006,0x0008}; 7
8 int main (void){
9 LUT_func();
10 Init_14Segment();
11 Init_UART();
12 Init_UART1();
13
14 while(1)
15 {
16 | if(received_go_signal)
17 | {
18 | UART0_Receive_DMA(index);
19 | index++;
20
21 | if(index > 10)
22 | {
23 | index = 0;
24 | CombineReceiveBuffer();
25 | ranges();
26 | }

27 | }
28 | if (receivedcal_val == 0)
29 | {
30 | AVG();
31 | int input = letter_decode();
32 | //in = 23;
33 | Display_Alphabet(input);
34 | }
35
36 }
37 }

Code for main header file on Reception MCU 1 #include <MKL25Z4.h>
2 #include "dma.h"
3 #include "cal.h"
4 #include "UART.h"
5 #include "adc.h"
6 #include "16Segment.h"
7
8 extern int screen_input;

Appendix B
Segments of MCU reference Manual

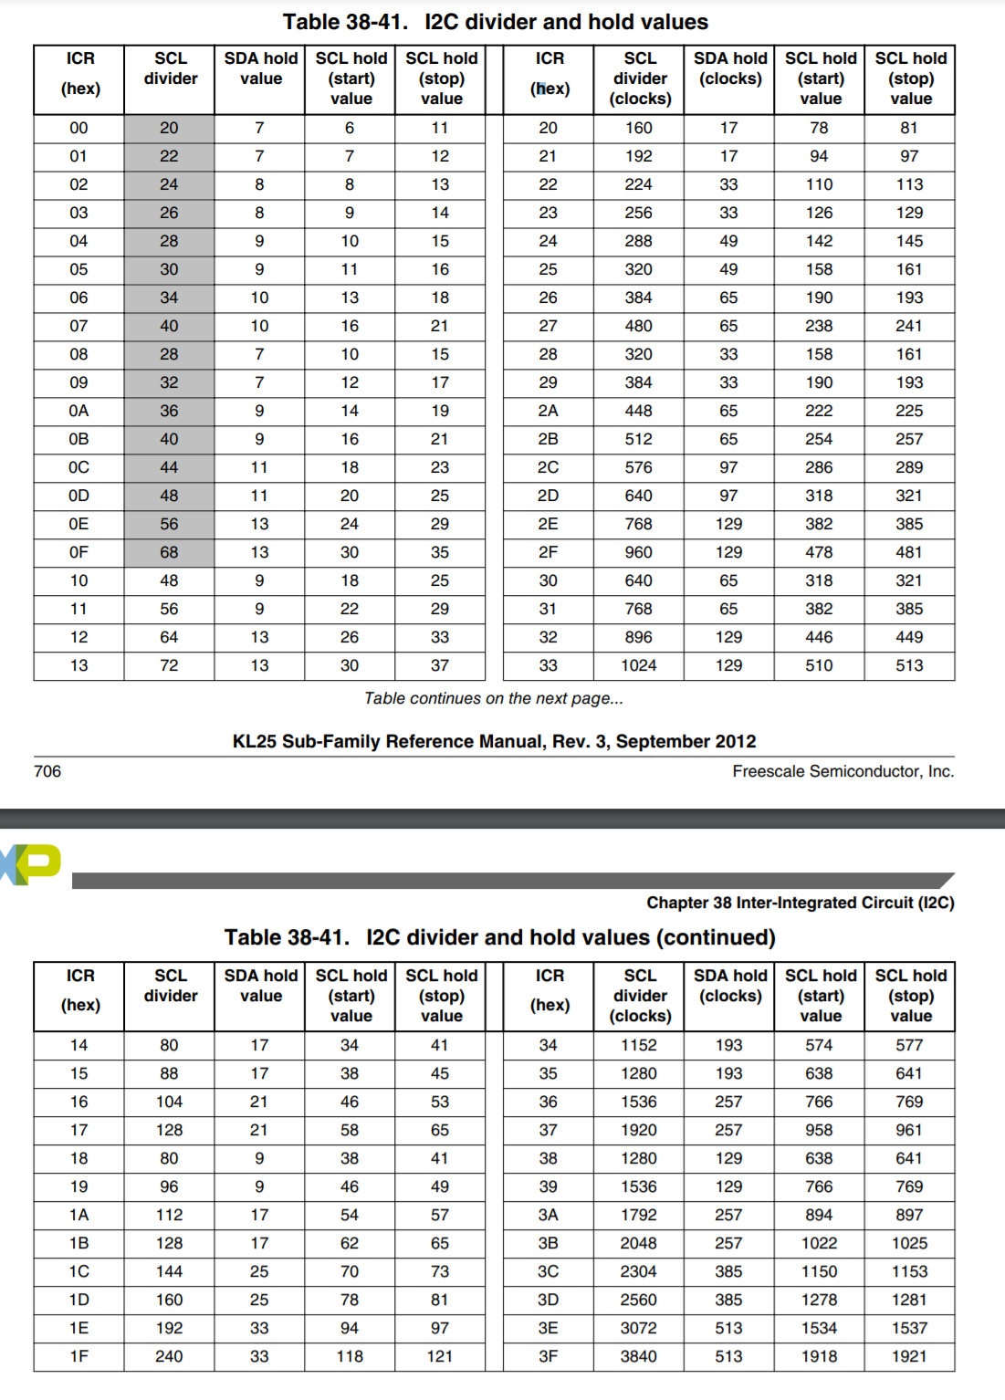
[picture p15: figure]
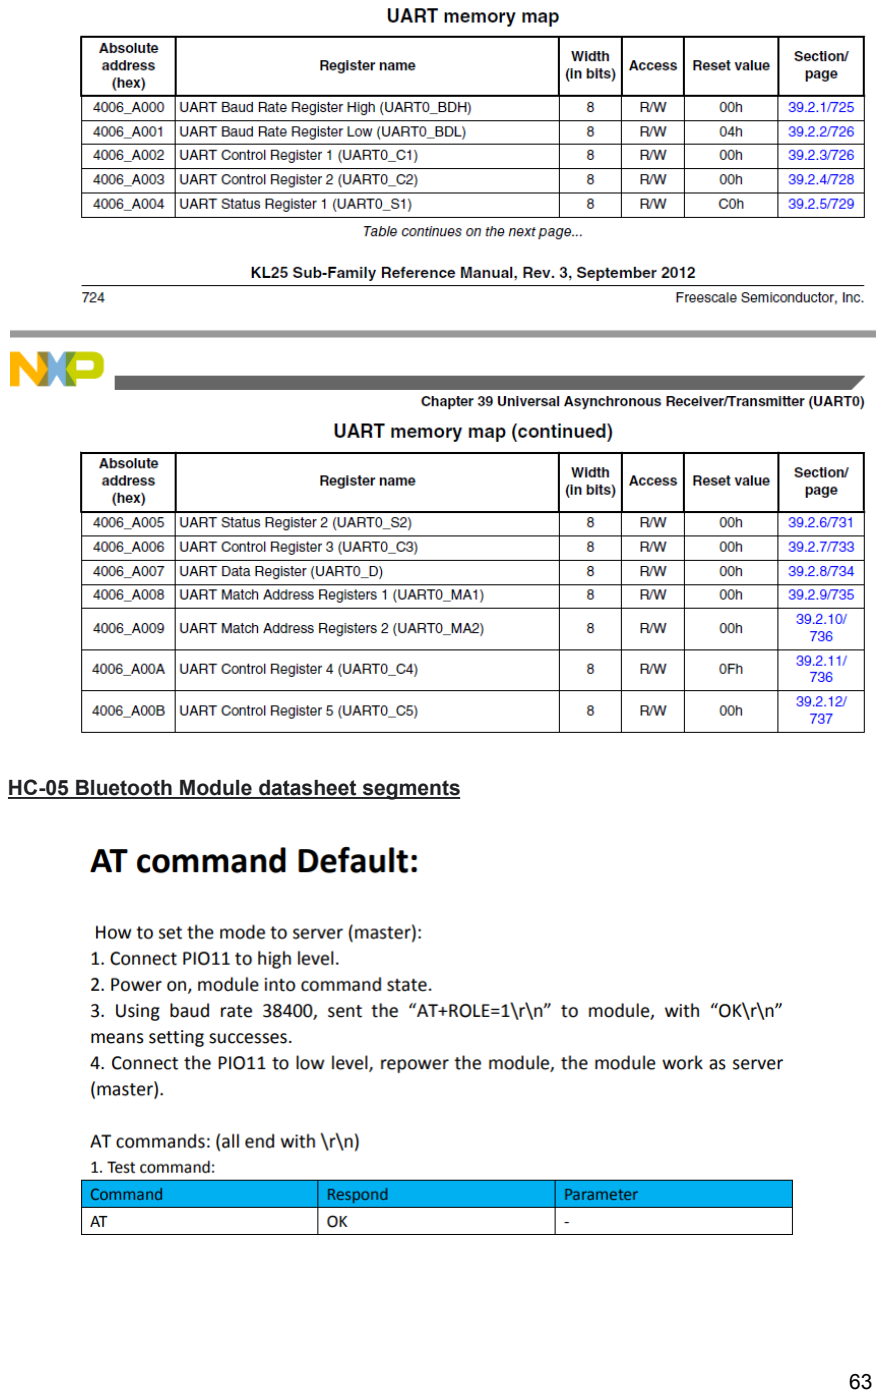
[picture p16: page 63]

HC-05 Bluetooth Module datasheet segments

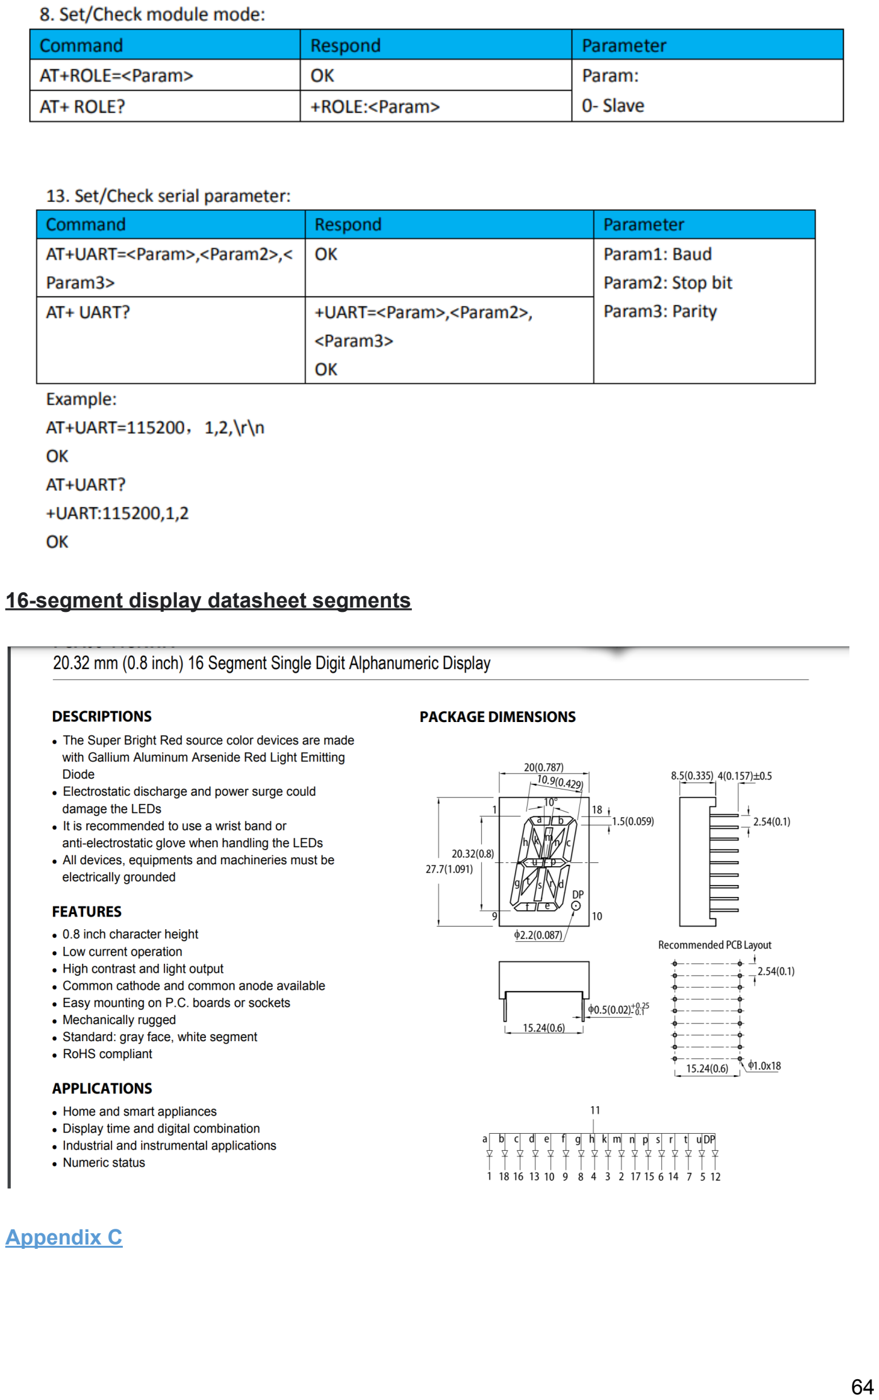
[picture p17: page 64]

16-segment display datasheet segments

Appendix C

Information on data formats and slave devices for I2C.
A device can have one or multiple registers where data is stored, written, or read. Data transfer may be initiated only when the bus is idle. A bus is considered idle if both SDA and SCL lines are high after a STOP condition.

The general procedure for a master to access a slave device is the following:

1. A master wants to send data to a slave:
- Master-transmitter sends a START condition and addresses the slave-receiver
- Master-transmitter sends data to slave-receiver
- Master-transmitter terminates the transfer with a STOP condition
2. A master wants to receive/read data from a slave:
- Master-receiver sends a START condition and addresses the slave-transmitter
- Master-receiver sends the requested register to read to slave-transmitter
- Master-receiver receives data from the slave-transmitter
- Master-receiver terminates the transfer with a STOP condition.
