SumatiGupta/ASL-Glove-Project/IntermediateCode/SPI-loopback-Sumi/LCD.h

#include <MKL25Z4.h>
#define MASK(x) (1UL<<(x))

#define DB0 (1) //on port B
#define DB1 (3) //on port B
#define DB2 (0) //on port B
#define DB3 (2) //on port B
#define RS  (1) //on port A
#define RW  (13)  //on port A
#define EN  (2) //on port A

void Init_LCD(void);
