SumatiGupta/ASL-Glove-Project/(commit log)

2021-11-29 Add files via upload
    Added UART1 to synchronize reception and transmission. Works. ADC, DMA, PIT, cal val update, UART0 and UART1.
2021-11-29 Add files via upload
    This file is the workaround to a certain problem we were having with the UART0 receiver module (more details further down). This file works with the Integrated Glove Final file.
    The problem with the UART0 receiver module that we were trying to solve with this workaround is the following:
    The receiver array does not synchronize with the transmitter array. That is, the transmitter MCU sends information regarding the flex sensors to the receiver MCU in the form of an array. The transmitter MCU has a transmit array, and the receiver MCU has a receive array. Logically, the two arrays should be identical. However, it was observed that the data in the receive array are n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
    [UART.c, UART.h, adc.h, dma.h, main.c]
